john777100/Image_Signal_Processor/synthesis/top_syn.v

/////////////////////////////////////////////////////////////
// Created by: Synopsys DC Ultra(TM) in wire load mode
// Version   : N-2017.09-SP2
// Date      : Thu Jun  4 21:27:11 2020
/////////////////////////////////////////////////////////////


module demosaic ( clk, rst_n, valid, data_in, end_col, end_pic, RGB_valid, 
        RGB_data, color, col_last, pic_last );
  input [7:0] data_in;
  output [7:0] RGB_data;
  output [1:0] color;
  input clk, rst_n, valid, end_col, end_pic;
  output RGB_valid, col_last, pic_last;
  wire   \col1_r[0][7] , \col1_r[0][6] , \col1_r[0][5] , \col1_r[0][4] ,
         \col1_r[0][3] , \col1_r[0][2] , \col1_r[0][1] , \col1_r[0][0] ,
         \col1_r[1][7] , \col1_r[1][6] , \col1_r[1][5] , \col1_r[1][4] ,
         \col1_r[1][3] , \col1_r[1][2] , \col1_r[1][1] , \col1_r[1][0] ,
         \col1_r[2][7] , \col1_r[2][6] , \col1_r[2][5] , \col1_r[2][4] ,
         \col1_r[2][3] , \col1_r[2][2] , \col1_r[2][1] , \col1_r[2][0] ,
         \col1_r[3][7] , \col1_r[3][6] , \col1_r[3][5] , \col1_r[3][4] ,
         \col1_r[3][3] , \col1_r[3][2] , \col1_r[3][1] , \col1_r[3][0] ,
         \col1_r[4][7] , \col1_r[4][6] , \col1_r[4][5] , \col1_r[4][4] ,
         \col1_r[4][3] , \col1_r[4][2] , \col1_r[4][1] , \col1_r[4][0] ,
         \col1_r[5][7] , \col1_r[5][6] , \col1_r[5][5] , \col1_r[5][4] ,
         \col1_r[5][3] , \col1_r[5][2] , \col1_r[5][1] , \col1_r[5][0] ,
         \col1_r[6][7] , \col1_r[6][6] , \col1_r[6][5] , \col1_r[6][4] ,
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
         n1128, n1129, n1130, n1131, n1132, n1133, n1134, n1135, n1136, n1137,
         n1138, n1139, n1140, n1141, n1142, n1143, n1144, n1145, n1146, n1147,
         n1148, n1149, n1150, n1151, n1152, n1153, n1154, n1155, n1156, n1157,
         n1158, n1159, n1160, n1161, n1162, n1163, n1164, \intadd_9/CI ,
         \intadd_9/SUM[6] , \intadd_9/SUM[5] , \intadd_9/SUM[4] ,
         \intadd_9/SUM[3] , \intadd_9/SUM[2] , \intadd_9/SUM[1] ,
         \intadd_9/SUM[0] , \intadd_9/n7 , \intadd_9/n6 , \intadd_9/n5 ,
         \intadd_9/n4 , \intadd_9/n3 , \intadd_9/n2 , \intadd_9/n1 ,
         \intadd_10/CI , \intadd_10/SUM[6] , \intadd_10/SUM[5] ,
         \intadd_10/SUM[4] , \intadd_10/SUM[3] , \intadd_10/SUM[2] ,
         \intadd_10/SUM[1] , \intadd_10/SUM[0] , \intadd_10/n7 ,
         \intadd_10/n6 , \intadd_10/n5 , \intadd_10/n4 , \intadd_10/n3 ,
         \intadd_10/n2 , \intadd_10/n1 , \intadd_11/A[5] , \intadd_11/A[4] ,
         \intadd_11/A[3] , \intadd_11/A[2] , \intadd_11/A[1] ,
         \intadd_11/A[0] , \intadd_11/B[5] , \intadd_11/B[4] ,
         \intadd_11/B[3] , \intadd_11/B[2] , \intadd_11/B[1] ,
         \intadd_11/B[0] , \intadd_11/CI , \intadd_11/SUM[5] ,
         \intadd_11/SUM[4] , \intadd_11/SUM[3] , \intadd_11/SUM[2] ,
         \intadd_11/SUM[1] , \intadd_11/SUM[0] , \intadd_11/n6 ,
         \intadd_11/n5 , \intadd_11/n4 , \intadd_11/n3 , \intadd_11/n2 ,
         \intadd_11/n1 , \intadd_12/A[5] , \intadd_12/A[4] , \intadd_12/A[3] ,
         \intadd_12/A[2] , \intadd_12/A[1] , \intadd_12/A[0] ,
         \intadd_12/B[5] , \intadd_12/B[4] , \intadd_12/B[3] ,
         \intadd_12/B[2] , \intadd_12/B[1] , \intadd_12/B[0] , \intadd_12/CI ,
         \intadd_12/SUM[5] , \intadd_12/SUM[4] , \intadd_12/SUM[3] ,
         \intadd_12/SUM[2] , \intadd_12/SUM[1] , \intadd_12/SUM[0] ,
         \intadd_12/n6 , \intadd_12/n5 , \intadd_12/n4 , \intadd_12/n3 ,
         \intadd_12/n2 , \intadd_12/n1 , n1, n2, n3, n4, n5, n6, n7, n8, n9,
         n10, n11, n12, n13, n14, n15, n16, n17, n18, n19, n20, n21, n22, n23,
         n24, n25, n26, n27, n28, n29, n30, n31, n32, n33, n34, n35, n36, n37,
         n38, n39, n40, n41, n42, n43, n44, n45, n46, n47, n48, n49, n50, n51,
         n52, n53, n54, n55, n56, n57, n58, n59, n60, n61, n62, n63, n64, n65,
         n66, n67, n68, n69, n70, n71, n72, n73, n74, n75, n76, n77, n78, n79,
         n80, n81, n82, n83, n84, n85, n86, n87, n88, n89, n90, n91, n92, n93,
         n94, n95, n96, n97, n98, n99, n100, n101, n102, n103, n104, n105,
         n106, n107, n108, n109, n110, n111, n112, n113, n114, n115, n116,
         n117, n118, n119, n120, n121, n122, n123, n124, n125, n126, n127,
         n128, n129, n130, n131, n132, n133, n134, n135, n136, n137, n138,
         n139, n140, n141, n142, n143, n144, n145, n146, n147, n148, n149,
         n150, n151, n152, n153, n154, n155, n156, n157, n158, n159, n160,
         n161, n162, n163, n164, n165, n166, n167, n168, n169, n170, n171,
         n172, n173, n174, n175, n176, n177, n178, n179, n180, n181, n182,
         n183, n184, n185, n186, n187, n188, n189, n190, n191, n192, n193,
         n194, n195, n196, n197, n198, n199, n200, n201, n202, n203, n204,
         n205, n206, n207, n208, n209, n210, n211, n212, n213, n214, n215,
         n216, n217, n218, n219, n220, n221, n222, n223, n224, n225, n226,
         n227, n228, n229, n230, n231, n232, n233, n234, n235, n236, n237,
         n238, n239, n240, n241, n242, n243, n244, n245, n246, n247, n248,
         n249, n250, n251, n252, n253, n254, n255, n256, n257, n258, n259,
         n260, n261, n262, n263, n264, n265, n266, n267, n268, n269, n270,
         n271, n272, n273, n274, n275, n276, n277, n278, n279, n280, n281,
         n282, n283, n284, n285, n286, n287, n288, n289, n290, n291, n292,
         n293, n294, n295, n296, n297, n298, n299, n300, n301, n302, n303,
         n304, n305, n306, n307, n308, n309, n310, n311, n312, n313, n314,
         n315, n316, n317, n318, n319, n320, n321, n322, n323, n324, n325,
         n326, n327, n328, n329, n330, n331, n332, n333, n334, n335, n336,
         n337, n338, n339, n340, n341, n342, n343, n344, n345, n346, n347,
         n348, n349, n350, n351, n352, n353, n354, n355, n356, n357, n358,
         n359, n360, n361, n362, n363, n364, n365, n366, n367, n368, n369,
         n370, n371, n372, n373, n374, n375, n376, n377, n378, n379, n380,
         n381, n382, n383, n384, n385, n386, n387, n388, n389, n390, n391,
         n392, n393, n394, n395, n396, n397, n398, n399, n400, n401, n402,
         n403, n404, n405, n406, n407, n408, n409, n410, n411, n412, n413,
         n414, n415, n416, n417, n418, n419, n420, n421, n422, n423, n424,
         n425, n426, n427, n428, n429, n430, n431, n432, n433, n434, n435,
         n436, n437, n438, n439, n440, n441, n442, n443, n444, n445, n446,
         n447, n448, n449, n450, n451, n452, n453, n454, n455, n456, n457,
         n458, n459, n460, n461, n462, n463, n464, n465, n466, n467, n468,
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
  wire   [2:0] counter_r;
  wire   [7:0] pixel9;
  wire   [2:0] logic_state_r;
  wire   [9:0] up_sum_r;
  wire   [9:0] down_sum_r;
  wire   [9:0] hor_sum_r;
  wire   [9:0] ver_sum_r;
  wire   [7:0] cen_r;
  wire   [7:0] G_data_r;
  wire   [7:0] B_data_r;
  wire   [3:0] state_r;
  wire   [3:0] state_w;

  QDFFRBN end_col_r_reg ( .D(end_col), .CK(clk), .RB(n851), .Q(end_col_r) );
  QDFFRBN end_pic_r_reg ( .D(end_pic), .CK(clk), .RB(n851), .Q(end_pic_r) );
  QDFFRBN \counter_r_reg[0]  ( .D(n1161), .CK(clk), .RB(n853), .Q(counter_r[0]) );
  QDFFRBN \state_r_reg[3]  ( .D(state_w[3]), .CK(clk), .RB(n853), .Q(
        state_r[3]) );
  QDFFRBN \counter_r_reg[1]  ( .D(n1159), .CK(clk), .RB(n853), .Q(counter_r[1]) );
  QDFFRBN \counter_r_reg[2]  ( .D(n1160), .CK(clk), .RB(n853), .Q(counter_r[2]) );
  QDFFRBN \state_r_reg[2]  ( .D(state_w[2]), .CK(clk), .RB(n852), .Q(
        state_r[2]) );
  QDFFRBN \state_r_reg[1]  ( .D(state_w[1]), .CK(clk), .RB(n852), .Q(
        state_r[1]) );
  QDFFRBN \logic_state_r_reg[2]  ( .D(n1164), .CK(clk), .RB(n848), .Q(
        logic_state_r[2]) );
  QDFFRBN \logic_state_r_reg[0]  ( .D(n1162), .CK(clk), .RB(n848), .Q(
        logic_state_r[0]) );
  QDFFRBN \logic_state_r_reg[1]  ( .D(n1163), .CK(clk), .RB(n859), .Q(
        logic_state_r[1]) );
  QDFFRBN col_last_buf_r_reg ( .D(n973), .CK(clk), .RB(n890), .Q(
        col_last_buf_r) );
  QDFFRBN col_last_r_reg ( .D(n972), .CK(clk), .RB(n890), .Q(col_last) );
  QDFFRBN pic_last_buf_r_reg ( .D(n924), .CK(clk), .RB(n890), .Q(
        pic_last_buf_r) );
  QDFFRBN pic_last_r_reg ( .D(n923), .CK(clk), .RB(n849), .Q(pic_last) );
  QDFFRBN \col3_r_reg[0][7]  ( .D(n1158), .CK(clk), .RB(n849), .Q(
        \col3_r[0][7] ) );
  QDFFRBN \col3_r_reg[0][6]  ( .D(n1157), .CK(clk), .RB(n849), .Q(
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
        .O(n194) );
  AOI22S U407 ( .A1(n668), .A2(\col1_r[5][0] ), .B1(n667), .B2(\col1_r[3][0] ), 
        .O(n193) );
  AOI22S U408 ( .A1(n678), .A2(\col1_r[6][0] ), .B1(n792), .B2(\col1_r[4][0] ), 
        .O(n192) );
  ND3 U409 ( .I1(n194), .I2(n193), .I3(n192), .O(n195) );
  OAI22S U410 ( .A1(n472), .A2(n195), .B1(\col1_r[0][0] ), .B2(n195), .O(n212)
         );
  MOAI1S U411 ( .A1(n213), .A2(n212), .B1(n213), .B2(n212), .O(n196) );
  MOAI1S U412 ( .A1(n369), .A2(n196), .B1(hor_sum_r[0]), .B2(n370), .O(n954)
         );
  AOI22S U413 ( .A1(n416), .A2(\col3_r[1][1] ), .B1(n423), .B2(\col3_r[0][1] ), 
        .O(n201) );
  INV1S U414 ( .I(n604), .O(n790) );
  AOI22S U415 ( .A1(n737), .A2(\col3_r[5][1] ), .B1(n790), .B2(\col3_r[4][1] ), 
        .O(n200) );
  AOI22S U416 ( .A1(n738), .A2(\col3_r[2][1] ), .B1(n770), .B2(\col3_r[3][1] ), 
        .O(n199) );
  ND3 U417 ( .I1(n201), .I2(n200), .I3(n199), .O(n733) );
  MOAI1S U418 ( .A1(n732), .A2(n733), .B1(n732), .B2(n733), .O(n205) );
  AOI22S U419 ( .A1(n416), .A2(\col1_r[1][1] ), .B1(\col1_r[0][1] ), .B2(n287), 
        .O(n204) );
  AOI22S U420 ( .A1(n737), .A2(\col1_r[5][1] ), .B1(n781), .B2(\col1_r[4][1] ), 
        .O(n203) );
  AOI22S U421 ( .A1(\col1_r[2][1] ), .A2(n784), .B1(\col1_r[3][1] ), .B2(n775), 
        .O(n202) );
  ND3 U422 ( .I1(n204), .I2(n203), .I3(n202), .O(n734) );
  MOAI1S U423 ( .A1(n205), .A2(n734), .B1(n205), .B2(n734), .O(n207) );
  BUF1 U424 ( .I(n206), .O(n310) );
  MOAI1S U425 ( .A1(n363), .A2(n207), .B1(up_sum_r[1]), .B2(n310), .O(n933) );
  MOAI1S U426 ( .A1(\intadd_11/SUM[0] ), .A2(n300), .B1(up_sum_r[2]), .B2(n310), .O(n932) );
  INV1S U427 ( .I(n422), .O(n466) );
  AOI22S U428 ( .A1(n466), .A2(\col1_r[2][1] ), .B1(\col1_r[1][1] ), .B2(n287), 
        .O(n210) );
  INV1S U429 ( .I(n597), .O(n677) );
  INV1S U430 ( .I(n260), .O(n646) );
  AOI22S U431 ( .A1(n677), .A2(\col1_r[5][1] ), .B1(n646), .B2(\col1_r[3][1] ), 
        .O(n209) );
  AOI22S U432 ( .A1(n678), .A2(\col1_r[6][1] ), .B1(\col1_r[4][1] ), .B2(n775), 
        .O(n208) );
  ND3 U433 ( .I1(n210), .I2(n209), .I3(n208), .O(n211) );
  INV1S U434 ( .I(n415), .O(n495) );
  OAI22S U435 ( .A1(\col1_r[0][1] ), .A2(n211), .B1(n495), .B2(n211), .O(n707)
         );
  NR2 U436 ( .I1(n213), .I2(n212), .O(n709) );
  AOI22S U437 ( .A1(n466), .A2(\col3_r[2][1] ), .B1(n788), .B2(\col3_r[1][1] ), 
        .O(n216) );
  INV1S U438 ( .I(n260), .O(n676) );
  AOI22S U439 ( .A1(n668), .A2(\col3_r[5][1] ), .B1(n676), .B2(\col3_r[3][1] ), 
        .O(n215) );
  INV1S U440 ( .I(n742), .O(n467) );
  AOI22S U441 ( .A1(n467), .A2(\col3_r[6][1] ), .B1(n792), .B2(\col3_r[4][1] ), 
        .O(n214) );
  ND3 U442 ( .I1(n216), .I2(n215), .I3(n214), .O(n217) );
  AO12 U443 ( .B1(n495), .B2(\col3_r[0][1] ), .A1(n217), .O(n708) );
  MOAI1S U444 ( .A1(n709), .A2(n708), .B1(n709), .B2(n708), .O(n218) );
  MOAI1S U445 ( .A1(n707), .A2(n218), .B1(n707), .B2(n218), .O(n219) );
  MOAI1S U446 ( .A1(n369), .A2(n219), .B1(hor_sum_r[1]), .B2(n310), .O(n953)
         );
  MOAI1S U447 ( .A1(\intadd_11/SUM[1] ), .A2(n300), .B1(up_sum_r[3]), .B2(n310), .O(n931) );
  MOAI1S U448 ( .A1(\intadd_12/SUM[0] ), .A2(n300), .B1(hor_sum_r[2]), .B2(
        n370), .O(n952) );
  MOAI1S U449 ( .A1(\intadd_11/SUM[2] ), .A2(n300), .B1(up_sum_r[4]), .B2(n310), .O(n930) );
  MOAI1S U450 ( .A1(\intadd_12/SUM[1] ), .A2(n372), .B1(hor_sum_r[3]), .B2(
        n370), .O(n951) );
  INV1S U451 ( .I(n623), .O(n615) );
  AOI22S U452 ( .A1(n615), .A2(\col1_r[7][5] ), .B1(n555), .B2(\col1_r[1][5] ), 
        .O(n224) );
  INV1S U453 ( .I(n743), .O(n350) );
  INV1S U454 ( .I(n589), .O(n337) );
  AOI22S U455 ( .A1(n350), .A2(\col1_r[4][5] ), .B1(n337), .B2(\col1_r[5][5] ), 
        .O(n223) );
  INV1S U456 ( .I(n417), .O(n347) );
  AOI22S U457 ( .A1(n291), .A2(\col1_r[3][5] ), .B1(n347), .B2(\col1_r[6][5] ), 
        .O(n221) );
  INV1S U458 ( .I(n736), .O(n563) );
  AOI22S U459 ( .A1(n563), .A2(\col1_r[2][5] ), .B1(n154), .B2(\col1_r[0][5] ), 
        .O(n220) );
  AN2 U460 ( .I1(n221), .I2(n220), .O(n222) );
  ND3 U461 ( .I1(n224), .I2(n223), .I3(n222), .O(n307) );
  INV1S U462 ( .I(n742), .O(n782) );
  AOI22S U463 ( .A1(n782), .A2(\col1_r[7][4] ), .B1(n555), .B2(\col1_r[1][4] ), 
        .O(n229) );
  INV1S U464 ( .I(n743), .O(n338) );
  INV1S U465 ( .I(n589), .O(n524) );
  AOI22S U466 ( .A1(n338), .A2(\col1_r[4][4] ), .B1(n524), .B2(\col1_r[5][4] ), 
        .O(n228) );
  INV1S U467 ( .I(n735), .O(n346) );
  INV1S U468 ( .I(n604), .O(n341) );
  AOI22S U469 ( .A1(n346), .A2(\col1_r[3][4] ), .B1(n341), .B2(\col1_r[6][4] ), 
        .O(n226) );
  AOI22S U470 ( .A1(n563), .A2(\col1_r[2][4] ), .B1(n155), .B2(\col1_r[0][4] ), 
        .O(n225) );
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
  MOAI1S U602 ( .A1(n369), .A2(n336), .B1(n717), .B2(ver_sum_r[6]), .O(n958)
         );
  MOAI1S U603 ( .A1(\intadd_12/SUM[3] ), .A2(n372), .B1(hor_sum_r[5]), .B2(
        n370), .O(n949) );
  AOI22S U604 ( .A1(n338), .A2(\col2_r[4][7] ), .B1(n337), .B2(\col2_r[5][7] ), 
        .O(n340) );
  AOI22S U605 ( .A1(n495), .A2(\col2_r[1][7] ), .B1(n393), .B2(\col2_r[7][7] ), 
        .O(n339) );
  AN2 U606 ( .I1(n340), .I2(n339), .O(n345) );
  AOI22S U607 ( .A1(n346), .A2(\col2_r[3][7] ), .B1(n341), .B2(\col2_r[6][7] ), 
        .O(n344) );
  AOI22S U608 ( .A1(n342), .A2(\col2_r[2][7] ), .B1(\col2_r[0][7] ), .B2(n154), 
        .O(n343) );
  ND3 U609 ( .I1(n345), .I2(n344), .I3(n343), .O(n366) );
  AOI22S U610 ( .A1(n346), .A2(\col2_r[1][7] ), .B1(n522), .B2(\col2_r[0][7] ), 
        .O(n353) );
  AOI22S U611 ( .A1(n348), .A2(\col2_r[5][7] ), .B1(n347), .B2(\col2_r[4][7] ), 
        .O(n352) );
  AOI22S U612 ( .A1(n350), .A2(\col2_r[2][7] ), .B1(n349), .B2(\col2_r[3][7] ), 
        .O(n351) );
  ND3 U613 ( .I1(n353), .I2(n352), .I3(n351), .O(n365) );
  FA1S U614 ( .A(n356), .B(n355), .CI(n354), .CO(n364), .S(n335) );
  INV1S U615 ( .I(n357), .O(n358) );
  MOAI1S U616 ( .A1(n369), .A2(n358), .B1(n717), .B2(ver_sum_r[8]), .O(n956)
         );
  FA1S U617 ( .A(n130), .B(n360), .CI(n359), .CO(n318), .S(n361) );
  INV1S U618 ( .I(n361), .O(n362) );
  MOAI1S U619 ( .A1(n363), .A2(n362), .B1(n24), .B2(down_sum_r[7]), .O(n937)
         );
  MOAI1S U620 ( .A1(\intadd_11/SUM[5] ), .A2(n798), .B1(up_sum_r[7]), .B2(n797), .O(n927) );
  FA1S U621 ( .A(n366), .B(n365), .CI(n364), .CO(n357), .S(n367) );
  INV1S U622 ( .I(n367), .O(n368) );
  MOAI1S U623 ( .A1(n369), .A2(n368), .B1(n717), .B2(ver_sum_r[7]), .O(n957)
         );
  MOAI1S U624 ( .A1(\intadd_12/SUM[4] ), .A2(n372), .B1(hor_sum_r[6]), .B2(n24), .O(n948) );
  MOAI1S U625 ( .A1(\intadd_12/SUM[5] ), .A2(n372), .B1(hor_sum_r[7]), .B2(
        n370), .O(n947) );
  MOAI1S U626 ( .A1(\intadd_12/n1 ), .A2(n372), .B1(hor_sum_r[8]), .B2(n371), 
        .O(n946) );
  NR2 U627 ( .I1(n509), .I2(n376), .O(n373) );
  NR3 U628 ( .I1(n509), .I2(logic_state_r[1]), .I3(logic_state_r[2]), .O(n374)
         );
  AOI22S U629 ( .A1(cen_r[1]), .A2(n127), .B1(B_data_r[1]), .B2(n100), .O(n379) );
  NR2 U630 ( .I1(logic_state_r[0]), .I2(n376), .O(n377) );
  AOI22S U631 ( .A1(n106), .A2(\intadd_9/SUM[1] ), .B1(ver_sum_r[2]), .B2(n126), .O(n378) );
  ND3 U632 ( .I1(n380), .I2(n379), .I3(n378), .O(n908) );
  AOI22S U633 ( .A1(cen_r[0]), .A2(n128), .B1(B_data_r[0]), .B2(n101), .O(n382) );
  AOI22S U634 ( .A1(n106), .A2(\intadd_9/SUM[0] ), .B1(ver_sum_r[1]), .B2(n125), .O(n381) );
  ND3 U635 ( .I1(n383), .I2(n382), .I3(n381), .O(n907) );
  AOI22S U636 ( .A1(cen_r[2]), .A2(n374), .B1(B_data_r[2]), .B2(n102), .O(n385) );
  AOI22S U637 ( .A1(n107), .A2(\intadd_9/SUM[2] ), .B1(ver_sum_r[3]), .B2(n377), .O(n384) );
  ND3 U638 ( .I1(n386), .I2(n385), .I3(n384), .O(n909) );
  AOI22S U639 ( .A1(cen_r[3]), .A2(n127), .B1(B_data_r[3]), .B2(n100), .O(n388) );
  AOI22S U640 ( .A1(n108), .A2(\intadd_9/SUM[3] ), .B1(ver_sum_r[4]), .B2(n126), .O(n387) );
  ND3 U641 ( .I1(n389), .I2(n388), .I3(n387), .O(n910) );
  AOI22S U642 ( .A1(cen_r[4]), .A2(n128), .B1(B_data_r[4]), .B2(n101), .O(n391) );
  AOI22S U643 ( .A1(n107), .A2(\intadd_9/SUM[4] ), .B1(ver_sum_r[5]), .B2(n125), .O(n390) );
  ND3 U644 ( .I1(n392), .I2(n391), .I3(n390), .O(n911) );
  NR2 U645 ( .I1(n393), .I2(end_col_r), .O(n538) );
  INV1S U646 ( .I(n538), .O(n492) );
  NR2 U647 ( .I1(n492), .I2(n409), .O(n474) );
  INV1S U648 ( .I(n505), .O(n520) );
  INV1S U649 ( .I(n21), .O(n497) );
  AOI22S U650 ( .A1(n474), .A2(n528), .B1(n109), .B2(n497), .O(n398) );
  INV1S U651 ( .I(end_col_r), .O(n631) );
  MOAI1S U652 ( .A1(n503), .A2(state_r[2]), .B1(n503), .B2(n18), .O(n394) );
  INV1S U653 ( .I(state_r[1]), .O(n487) );
  AO13S U654 ( .B1(n116), .B2(n540), .B3(n394), .A1(n487), .O(n397) );
  NR2 U655 ( .I1(n847), .I2(n623), .O(n395) );
  INV1S U656 ( .I(n532), .O(n476) );
  ND3 U657 ( .I1(n398), .I2(n397), .I3(n396), .O(state_w[1]) );
  AOI22S U658 ( .A1(cen_r[5]), .A2(n374), .B1(B_data_r[5]), .B2(n102), .O(n400) );
  AOI22S U659 ( .A1(n106), .A2(\intadd_9/SUM[5] ), .B1(ver_sum_r[6]), .B2(n377), .O(n399) );
  ND3 U660 ( .I1(n401), .I2(n400), .I3(n399), .O(n912) );
  ND2S U661 ( .I1(n128), .I2(cen_r[7]), .O(n404) );
  AOI22S U662 ( .A1(hor_sum_r[8]), .A2(n373), .B1(B_data_r[7]), .B2(n100), .O(
        n403) );
  AOI22S U663 ( .A1(n107), .A2(\intadd_9/n1 ), .B1(ver_sum_r[8]), .B2(n126), 
        .O(n402) );
  ND3 U664 ( .I1(n404), .I2(n403), .I3(n402), .O(n914) );
  AOI22S U665 ( .A1(cen_r[6]), .A2(n127), .B1(B_data_r[6]), .B2(n101), .O(n406) );
  AOI22S U666 ( .A1(n108), .A2(\intadd_9/SUM[6] ), .B1(ver_sum_r[7]), .B2(n125), .O(n405) );
  ND3 U667 ( .I1(n407), .I2(n406), .I3(n405), .O(n913) );
  ND2S U668 ( .I1(RGB_valid), .I2(n809), .O(n408) );
  ND2S U669 ( .I1(n408), .I2(n75), .O(RGB_valid_w) );
  ND2S U670 ( .I1(n811), .I2(n410), .O(n1163) );
  AOI22S U671 ( .A1(n416), .A2(\col1_r[2][7] ), .B1(n423), .B2(\col1_r[1][7] ), 
        .O(n413) );
  INV1S U672 ( .I(n597), .O(n661) );
  AOI22S U673 ( .A1(n661), .A2(\col1_r[5][7] ), .B1(n523), .B2(\col1_r[3][7] ), 
        .O(n412) );
  AOI22S U674 ( .A1(n737), .A2(\col1_r[6][7] ), .B1(n436), .B2(\col1_r[4][7] ), 
        .O(n411) );
  ND3 U675 ( .I1(n413), .I2(n412), .I3(n411), .O(n414) );
  OAI22S U676 ( .A1(n521), .A2(n414), .B1(\col1_r[0][7] ), .B2(n414), .O(
        \intadd_12/B[5] ) );
  INV1S U677 ( .I(n415), .O(n446) );
  AOI22S U678 ( .A1(n416), .A2(\col3_r[2][7] ), .B1(n423), .B2(\col3_r[1][7] ), 
        .O(n420) );
  INV1S U679 ( .I(n417), .O(n653) );
  AOI22S U680 ( .A1(n653), .A2(\col3_r[5][7] ), .B1(n676), .B2(\col3_r[3][7] ), 
        .O(n419) );
  INV1S U681 ( .I(n742), .O(n441) );
  AOI22S U682 ( .A1(n441), .A2(\col3_r[6][7] ), .B1(n436), .B2(\col3_r[4][7] ), 
        .O(n418) );
  ND3 U683 ( .I1(n420), .I2(n419), .I3(n418), .O(n421) );
  OAI22S U684 ( .A1(n446), .A2(n421), .B1(\col3_r[0][7] ), .B2(n421), .O(
        \intadd_12/A[5] ) );
  INV1S U685 ( .I(n422), .O(n447) );
  AOI22S U686 ( .A1(n447), .A2(\col1_r[2][6] ), .B1(n423), .B2(\col1_r[1][6] ), 
        .O(n426) );
  AOI22S U687 ( .A1(n653), .A2(\col1_r[5][6] ), .B1(n523), .B2(\col1_r[3][6] ), 
        .O(n425) );
  AOI22S U688 ( .A1(n441), .A2(\col1_r[6][6] ), .B1(n436), .B2(\col1_r[4][6] ), 
        .O(n424) );
  ND3 U689 ( .I1(n426), .I2(n425), .I3(n424), .O(n427) );
  OAI22S U690 ( .A1(n446), .A2(n427), .B1(\col1_r[0][6] ), .B2(n427), .O(
        \intadd_12/B[4] ) );
  INV1S U691 ( .I(n566), .O(n452) );
  AOI22S U692 ( .A1(n447), .A2(\col3_r[2][6] ), .B1(n452), .B2(\col3_r[1][6] ), 
        .O(n430) );
  AOI22S U693 ( .A1(n661), .A2(\col3_r[5][6] ), .B1(n676), .B2(\col3_r[3][6] ), 
        .O(n429) );
  AOI22S U694 ( .A1(n441), .A2(\col3_r[6][6] ), .B1(n436), .B2(\col3_r[4][6] ), 
        .O(n428) );
  ND3 U695 ( .I1(n430), .I2(n429), .I3(n428), .O(n431) );
  OAI22S U696 ( .A1(n446), .A2(n431), .B1(\col3_r[0][6] ), .B2(n431), .O(
        \intadd_12/A[4] ) );
  AOI22S U697 ( .A1(n447), .A2(\col1_r[2][5] ), .B1(n452), .B2(\col1_r[1][5] ), 
        .O(n434) );
  AOI22S U698 ( .A1(n653), .A2(\col1_r[5][5] ), .B1(n523), .B2(\col1_r[3][5] ), 
        .O(n433) );
  INV1S U699 ( .I(n747), .O(n461) );
  AOI22S U700 ( .A1(n441), .A2(\col1_r[6][5] ), .B1(n461), .B2(\col1_r[4][5] ), 
        .O(n432) );
  ND3 U701 ( .I1(n434), .I2(n433), .I3(n432), .O(n435) );
  OAI22S U702 ( .A1(n446), .A2(n435), .B1(\col1_r[0][5] ), .B2(n435), .O(
        \intadd_12/B[3] ) );
  AOI22S U703 ( .A1(n447), .A2(\col3_r[2][5] ), .B1(n452), .B2(\col3_r[1][5] ), 
        .O(n439) );
  AOI22S U704 ( .A1(n677), .A2(\col3_r[5][5] ), .B1(n676), .B2(\col3_r[3][5] ), 
        .O(n438) );
  AOI22S U705 ( .A1(n441), .A2(\col3_r[6][5] ), .B1(n436), .B2(\col3_r[4][5] ), 
        .O(n437) );
  ND3 U706 ( .I1(n439), .I2(n438), .I3(n437), .O(n440) );
  OAI22S U707 ( .A1(n446), .A2(n440), .B1(\col3_r[0][5] ), .B2(n440), .O(
        \intadd_12/A[3] ) );
  AOI22S U708 ( .A1(n447), .A2(\col1_r[2][4] ), .B1(n452), .B2(\col1_r[1][4] ), 
        .O(n444) );
  AOI22S U709 ( .A1(n661), .A2(\col1_r[5][4] ), .B1(n646), .B2(\col1_r[3][4] ), 
        .O(n443) );
  AOI22S U710 ( .A1(n441), .A2(\col1_r[6][4] ), .B1(n461), .B2(\col1_r[4][4] ), 
        .O(n442) );
  ND3 U711 ( .I1(n444), .I2(n443), .I3(n442), .O(n445) );
  OAI22S U712 ( .A1(n446), .A2(n445), .B1(\col1_r[0][4] ), .B2(n445), .O(
        \intadd_12/B[2] ) );
  AOI22S U713 ( .A1(n447), .A2(\col3_r[2][4] ), .B1(n452), .B2(\col3_r[1][4] ), 
        .O(n450) );
  AOI22S U714 ( .A1(n677), .A2(\col3_r[5][4] ), .B1(n646), .B2(\col3_r[3][4] ), 
        .O(n449) );
  AOI22S U715 ( .A1(n467), .A2(\col3_r[6][4] ), .B1(n461), .B2(\col3_r[4][4] ), 
        .O(n448) );
  ND3 U716 ( .I1(n450), .I2(n449), .I3(n448), .O(n451) );
  OAI22S U717 ( .A1(n472), .A2(n451), .B1(\col3_r[0][4] ), .B2(n451), .O(
        \intadd_12/A[2] ) );
  AOI22S U718 ( .A1(n466), .A2(\col1_r[2][3] ), .B1(n452), .B2(\col1_r[1][3] ), 
        .O(n455) );
  AOI22S U719 ( .A1(n661), .A2(\col1_r[5][3] ), .B1(n523), .B2(\col1_r[3][3] ), 
        .O(n454) );
  AOI22S U720 ( .A1(n467), .A2(\col1_r[6][3] ), .B1(n461), .B2(\col1_r[4][3] ), 
        .O(n453) );
  ND3 U721 ( .I1(n455), .I2(n454), .I3(n453), .O(n456) );
  OAI22S U722 ( .A1(n472), .A2(n456), .B1(\col1_r[0][3] ), .B2(n456), .O(
        \intadd_12/B[1] ) );
  AOI22S U723 ( .A1(n466), .A2(\col3_r[2][3] ), .B1(n788), .B2(\col3_r[1][3] ), 
        .O(n459) );
  AOI22S U724 ( .A1(n653), .A2(\col3_r[5][3] ), .B1(n646), .B2(\col3_r[3][3] ), 
        .O(n458) );
  AOI22S U725 ( .A1(n467), .A2(\col3_r[6][3] ), .B1(n461), .B2(\col3_r[4][3] ), 
        .O(n457) );
  ND3 U726 ( .I1(n459), .I2(n458), .I3(n457), .O(n460) );
  OAI22S U727 ( .A1(n472), .A2(n460), .B1(\col3_r[0][3] ), .B2(n460), .O(
        \intadd_12/A[1] ) );
  AOI22S U728 ( .A1(n466), .A2(\col1_r[2][2] ), .B1(n788), .B2(\col1_r[1][2] ), 
        .O(n464) );
  AOI22S U729 ( .A1(n661), .A2(\col1_r[5][2] ), .B1(n646), .B2(\col1_r[3][2] ), 
        .O(n463) );
  AOI22S U730 ( .A1(n467), .A2(\col1_r[6][2] ), .B1(n461), .B2(\col1_r[4][2] ), 
        .O(n462) );
  ND3 U731 ( .I1(n464), .I2(n463), .I3(n462), .O(n465) );
  OAI22S U732 ( .A1(n472), .A2(n465), .B1(\col1_r[0][2] ), .B2(n465), .O(
        \intadd_12/CI ) );
  AOI22S U733 ( .A1(n466), .A2(\col3_r[2][2] ), .B1(n788), .B2(\col3_r[1][2] ), 
        .O(n470) );
  AOI22S U734 ( .A1(n668), .A2(\col3_r[5][2] ), .B1(n676), .B2(\col3_r[3][2] ), 
        .O(n469) );
  AOI22S U735 ( .A1(n467), .A2(\col3_r[6][2] ), .B1(n792), .B2(\col3_r[4][2] ), 
        .O(n468) );
  ND3 U736 ( .I1(n470), .I2(n469), .I3(n468), .O(n471) );
  OAI22S U737 ( .A1(n472), .A2(n471), .B1(\col3_r[0][2] ), .B2(n471), .O(
        \intadd_12/B[0] ) );
  NR2 U738 ( .I1(n532), .I2(n505), .O(n488) );
  AOI13HS U739 ( .B1(state_r[2]), .B2(n503), .B3(n505), .A1(n488), .O(n535) );
  AO13S U740 ( .B1(n528), .B2(n531), .B3(n498), .A1(state_r[3]), .O(n473) );
  AOI22S U741 ( .A1(n116), .A2(n475), .B1(n474), .B2(n505), .O(n517) );
  OA12 U742 ( .B1(n21), .B2(n520), .A1(state_r[3]), .O(n500) );
  AOI13HS U743 ( .B1(n476), .B2(n487), .B3(n847), .A1(n500), .O(n530) );
  MOAI1S U744 ( .A1(counter_r[0]), .A2(n517), .B1(counter_r[0]), .B2(n515), 
        .O(n1161) );
  AOI13HS U745 ( .B1(state_r[1]), .B2(n113), .B3(n631), .A1(n497), .O(n477) );
  INV1S U746 ( .I(n115), .O(n533) );
  NR2 U747 ( .I1(n477), .I2(n533), .O(n482) );
  ND2S U748 ( .I1(n18), .I2(n631), .O(n478) );
  AOI22S U749 ( .A1(state_r[3]), .A2(n478), .B1(state_r[1]), .B2(n782), .O(
        n480) );
  AOI13HS U750 ( .B1(n480), .B2(n505), .B3(n479), .A1(n21), .O(n481) );
  MOAI1S U751 ( .A1(n482), .A2(n847), .B1(n116), .B2(n481), .O(state_w[0]) );
  NR2 U752 ( .I1(n109), .I2(n495), .O(n483) );
  NR3 U753 ( .I1(state_r[3]), .I2(n484), .I3(n483), .O(n491) );
  ND2S U754 ( .I1(state_r[0]), .I2(n485), .O(n486) );
  ND3 U755 ( .I1(n487), .I2(n631), .I3(n486), .O(n489) );
  MOAI1S U756 ( .A1(n113), .A2(n489), .B1(n488), .B2(n495), .O(n490) );
  MOAI1S U757 ( .A1(n491), .A2(n497), .B1(n115), .B2(n490), .O(state_w[2]) );
  NR2 U758 ( .I1(state_r[1]), .I2(n18), .O(n493) );
  NR2 U759 ( .I1(n493), .I2(n492), .O(n494) );
  NR2 U760 ( .I1(n494), .I2(n533), .O(n502) );
  NR2 U761 ( .I1(n520), .I2(n497), .O(n496) );
  MOAI1S U762 ( .A1(n498), .A2(n497), .B1(n496), .B2(n495), .O(n499) );
  NR2 U763 ( .I1(n500), .I2(n499), .O(n501) );
  OAI22S U764 ( .A1(n113), .A2(n502), .B1(n533), .B2(n501), .O(state_w[3]) );
  NR2 U765 ( .I1(n811), .I2(logic_state_r[1]), .O(n842) );
  INV1S U766 ( .I(n531), .O(n504) );
  MOAI1S U767 ( .A1(n505), .A2(n518), .B1(n519), .B2(n504), .O(n506) );
  OR3B2S U768 ( .I1(n77), .B1(n115), .B2(n506), .O(n507) );
  OAI112HS U769 ( .C1(n510), .C2(n509), .A1(n508), .B1(n507), .O(n1162) );
  XOR2HS U770 ( .I1(n511), .I2(counter_r[2]), .O(n512) );
  MOAI1S U771 ( .A1(n512), .A2(n517), .B1(n23), .B2(n515), .O(n1160) );
  AN2 U772 ( .I1(n514), .I2(n513), .O(n516) );
  MOAI1S U773 ( .A1(n517), .A2(n516), .B1(counter_r[1]), .B2(n515), .O(n1159)
         );
  MOAI1S U774 ( .A1(n520), .A2(n519), .B1(n520), .B2(n518), .O(n537) );
  OAI22S U775 ( .A1(n535), .A2(n533), .B1(n537), .B2(n533), .O(n525) );
  MOAI1S U776 ( .A1(n129), .A2(n83), .B1(\col3_r[0][7] ), .B2(n81), .O(n1158)
         );
  MOAI1S U777 ( .A1(n132), .A2(n81), .B1(\col3_r[0][6] ), .B2(n82), .O(n1157)
         );
  MOAI1S U778 ( .A1(n135), .A2(n82), .B1(\col3_r[0][5] ), .B2(n83), .O(n1156)
         );
  MOAI1S U779 ( .A1(n138), .A2(n83), .B1(\col3_r[0][4] ), .B2(n81), .O(n1155)
         );
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
  AOI22S U1111 ( .A1(n782), .A2(\col1_r[5][6] ), .B1(n774), .B2(\col1_r[4][6] ), .O(n777) );
  AOI22S U1112 ( .A1(n784), .A2(\col1_r[2][6] ), .B1(n775), .B2(\col1_r[3][6] ), .O(n776) );
  AOI22S U1113 ( .A1(n780), .A2(\col3_r[1][7] ), .B1(n779), .B2(\col3_r[0][7] ), .O(n787) );
  AOI22S U1114 ( .A1(n782), .A2(\col3_r[5][7] ), .B1(n781), .B2(\col3_r[4][7] ), .O(n786) );
  AOI22S U1115 ( .A1(n784), .A2(\col3_r[2][7] ), .B1(n783), .B2(\col3_r[3][7] ), .O(n785) );
  AOI22S U1116 ( .A1(n789), .A2(\col1_r[1][7] ), .B1(n788), .B2(\col1_r[0][7] ), .O(n796) );
  AOI22S U1117 ( .A1(n791), .A2(\col1_r[5][7] ), .B1(n790), .B2(\col1_r[4][7] ), .O(n795) );
  AOI22S U1118 ( .A1(n793), .A2(\col1_r[2][7] ), .B1(n792), .B2(\col1_r[3][7] ), .O(n794) );
  MOAI1S U1119 ( .A1(\intadd_11/n1 ), .A2(n798), .B1(up_sum_r[8]), .B2(n797), 
        .O(n926) );
  INV1S U1120 ( .I(end_pic_r), .O(n800) );
  MOAI1S U1121 ( .A1(n801), .A2(n800), .B1(n799), .B2(pic_last_buf_r), .O(n924) );
  NR2 U1122 ( .I1(ver_sum_r[1]), .I2(hor_sum_r[1]), .O(n803) );
  ND2S U1123 ( .I1(ver_sum_r[0]), .I2(hor_sum_r[0]), .O(n802) );
  MOAI1S U1124 ( .A1(n803), .A2(n802), .B1(ver_sum_r[1]), .B2(hor_sum_r[1]), 
        .O(\intadd_10/CI ) );
  AO222 U1125 ( .A1(n100), .A2(G_data_r[7]), .B1(n66), .B2(\intadd_10/n1 ), 
        .C1(cen_r[7]), .C2(n804), .O(n922) );
  AO222 U1126 ( .A1(n65), .A2(\intadd_10/SUM[6] ), .B1(n102), .B2(G_data_r[6]), 
        .C1(cen_r[6]), .C2(n804), .O(n921) );
  AO222 U1127 ( .A1(n66), .A2(\intadd_10/SUM[5] ), .B1(n100), .B2(G_data_r[5]), 
        .C1(cen_r[5]), .C2(n804), .O(n920) );
  AO222 U1128 ( .A1(n65), .A2(\intadd_10/SUM[4] ), .B1(n101), .B2(G_data_r[4]), 
        .C1(cen_r[4]), .C2(n804), .O(n919) );
  AO222 U1129 ( .A1(n66), .A2(\intadd_10/SUM[3] ), .B1(n102), .B2(G_data_r[3]), 
        .C1(cen_r[3]), .C2(n804), .O(n918) );
  AO222 U1130 ( .A1(n65), .A2(\intadd_10/SUM[2] ), .B1(n100), .B2(G_data_r[2]), 
        .C1(cen_r[2]), .C2(n112), .O(n917) );
  AO222 U1131 ( .A1(n66), .A2(\intadd_10/SUM[1] ), .B1(n101), .B2(G_data_r[1]), 
        .C1(cen_r[1]), .C2(n112), .O(n916) );
  AO222 U1132 ( .A1(n65), .A2(\intadd_10/SUM[0] ), .B1(n102), .B2(G_data_r[0]), 
        .C1(cen_r[0]), .C2(n112), .O(n915) );
  NR2 U1133 ( .I1(down_sum_r[1]), .I2(up_sum_r[1]), .O(n806) );
  ND2S U1134 ( .I1(down_sum_r[0]), .I2(up_sum_r[0]), .O(n805) );
  MOAI1S U1135 ( .A1(n806), .A2(n805), .B1(down_sum_r[1]), .B2(up_sum_r[1]), 
        .O(\intadd_9/CI ) );
  ND2S U1136 ( .I1(logic_state_r[1]), .I2(n20), .O(n808) );
  ND2S U1137 ( .I1(n809), .I2(n808), .O(n807) );
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
