john777100/Image_Signal_Processor/apr/top_syn.v

/////////////////////////////////////////////////////////////
// Created by: Synopsys DC Ultra(TM) in wire load mode
// Version   : N-2017.09-SP2
// Date      : Fri May 29 00:54:54 2020
/////////////////////////////////////////////////////////////


module demosaic ( clk, rst_n, valid, data_in, end_col, end_pic, RGB_valid, 
        RGB_data, color, col_last, pic_last );
  input [7:0] data_in;
  output [7:0] RGB_data;
  output [1:0] color;
  input clk, rst_n, valid, end_col, end_pic;
  output RGB_valid, col_last, pic_last;
  wire   \col1_r[0][0] , \col1_r[1][0] , \col1_r[4][1] , \col2_r[4][7] ,
         \col2_r[4][6] , \col2_r[4][5] , \col2_r[4][4] , \col2_r[4][3] ,
         \col2_r[4][2] , \col2_r[4][1] , \col2_r[4][0] , \col3_r[0][1] ,
         \col3_r[0][0] , \col3_r[1][1] , \col3_r[1][0] , col_last_buf_r,
         pic_last_buf_r, end_col_r, end_pic_r, valid_r, RGB_valid_w, n1016,
         n1017, n1018, n1019, n1020, n1021, n1022, n1023, n1024, n1025, n1026,
         n1027, n1028, n1029, n1030, n1031, n1032, n1033, n1034, n1035, n1036,
         n1037, n1038, n1039, n1040, n1041, n1042, n1043, n1044, n1046, n1047,
         n1048, n1049, n1050, n1051, n1052, n1053, n1054, n1056, n1057, n1058,
         n1059, n1060, n1061, n1062, n1063, n1064, n1066, n1067, n1068, n1069,
         n1070, n1071, n1072, n1073, n1074, n1076, n1077, n1078, n1079, n1080,
         n1081, n1082, n1083, n1084, n1085, n1086, n1087, n1088, n1089, n1090,
         n1091, n1092, n1093, n1094, n1095, n1096, n1097, n1098, n1099, n1100,
         n1101, n1102, n1103, n1104, n1105, n1106, n1107, n1108, n1109, n1110,
         n1111, n1112, n1113, n1114, n1115, n1116, n1117, n1118, n1119, n1120,
         n1121, n1122, n1123, n1124, n1125, n1126, n1127, n1128, n1129, n1130,
         n1131, n1132, n1133, n1134, n1135, n1136, n1137, n1138, n1139, n1140,
         n1141, n1142, n1143, n1144, n1145, n1146, n1147, n1148, n1149, n1150,
         n1151, n1152, n1153, n1154, n1155, n1156, n1157, n1158, n1159, n1160,
         n1161, n1162, n1163, n1164, n1165, n1166, n1167, n1168, n1169, n1170,
         n1171, n1172, n1173, n1174, n1175, n1176, n1177, n1178, n1179, n1180,
         n1181, n1182, n1183, n1184, n1185, n1186, n1187, n1188, n1189, n1190,
         n1191, n1192, n1193, n1194, n1195, n1196, n1197, n1198, n1199, n1200,
         n1201, n1202, n1203, n1204, n1205, n1206, n1207, n1208, n1209, n1210,
         n1211, n1212, n1213, n1214, n1215, n1216, n1217, n1218, n1219, n1220,
         n1221, n1222, n1223, n1224, n1225, n1226, n1227, n1228, n1229, n1230,
         n1231, n1232, n1233, n1234, n1235, n1236, n1237, n1238, n1239, n1240,
         n1241, n1242, n1243, n1244, n1245, n1246, n1247, n1248, n1249, n1250,
         n1251, n1252, n1253, n1254, n1255, n1256, n1257, n1258, n1259, n1260,
         n1261, n1262, n1263, n1264, n1265, n1266, n1267, n1268, n1269, n1270,
         n1271, n1272, n1273, n1274, n1275, n1276, n1277, n1278, n1279, n1280,
         n1281, n1282, n1283, n1284, \intadd_7/CI , \intadd_7/SUM[6] ,
         \intadd_7/SUM[5] , \intadd_7/SUM[4] , \intadd_7/SUM[3] ,
         \intadd_7/SUM[2] , \intadd_7/SUM[1] , \intadd_7/SUM[0] ,
         \intadd_7/n7 , \intadd_7/n6 , \intadd_7/n5 , \intadd_7/n4 ,
         \intadd_7/n3 , \intadd_7/n2 , \intadd_7/n1 , \intadd_8/CI ,
         \intadd_8/SUM[6] , \intadd_8/SUM[5] , \intadd_8/SUM[4] ,
         \intadd_8/SUM[3] , \intadd_8/SUM[2] , \intadd_8/SUM[1] ,
         \intadd_8/SUM[0] , \intadd_8/n7 , \intadd_8/n6 , \intadd_8/n5 ,
         \intadd_8/n4 , \intadd_8/n3 , \intadd_8/n2 , \intadd_8/n1 ,
         \intadd_9/A[5] , \intadd_9/A[4] , \intadd_9/A[3] , \intadd_9/A[2] ,
         \intadd_9/A[1] , \intadd_9/A[0] , \intadd_9/B[5] , \intadd_9/B[4] ,
         \intadd_9/B[3] , \intadd_9/B[2] , \intadd_9/B[1] , \intadd_9/B[0] ,
         \intadd_9/CI , \intadd_9/SUM[5] , \intadd_9/SUM[4] ,
         \intadd_9/SUM[3] , \intadd_9/SUM[2] , \intadd_9/SUM[1] ,
         \intadd_9/SUM[0] , \intadd_9/n6 , \intadd_9/n5 , \intadd_9/n4 ,
         \intadd_9/n3 , \intadd_9/n2 , \intadd_9/n1 , n1, n2, n3, n4, n5, n6,
         n10, n11, n12, n13, n14, n15, n16, n17, n18, n19, n20, n21, n22, n23,
         n24, n25, n26, n27, n28, n29, n30, n31, n32, n33, n34, n35, n36, n37,
         n38, n39, n40, n41, n42, n43, n44, n45, n46, n47, n48, n49, n50, n51,
         n52, n53, n54, n55, n56, n57, n58, n59, n60, n61, n62, n63, n64, n65,
         n66, n67, n68, n69, n70, n71, n72, n73, n74, n75, n76, n77, n78, n79,
         n80, n81, n82, n83, n84, n85, n86, n87, n88, n89, n90, n91, n92, n93,
         n94, n95, n96, n97, n98, n99, n100, n101, n102, n103, n104, n105,
         n106, n107, n108, n109, n110, n111, n112, n113, n114, n115, n116,
         n117, n118, n119, n120, n121, n122, n123, n124, n125, n126, n127,
         n128, n129, n130, n131, n132, n133, n134, n135, n136, n137, n138,
         n139, n140, n141, n142, n143, n144, n145, n146, n147, n148, n149,
         n150, n151, n152, n153, n154, n155, n156, n157, n158, n159, n160,
         n161, n162, n163, n164, n165, n166, n167, n168, n169, n170, n171,
         n172, n173, n174, n175, n176, n177, n178, n179, n180, n181, n182,
         n183, n184, n185, n186, n187, n188, n189, n190, n191, n192, n193,
         n194, n195, n196, n197, n198, n199, n200, n201, n202, n203, n204,
         n205, n206, n207, n208, n209, n210, n211, n212, n213, n214, n215,
         n216, n217, n218, n219, n220, n221, n222, n223, n224, n225, n226,
         n227, n228, n229, n230, n231, n232, n233, n234, n235, n236, n237,
         n238, n239, n240, n241, n242, n243, n244, n245, n246, n247, n248,
         n249, n250, n251, n252, n253, n254, n255, n256, n257, n258, n259,
         n260, n261, n262, n263, n264, n265, n266, n267, n268, n269, n270,
         n271, n272, n273, n274, n275, n276, n277, n278, n279, n280, n281,
         n282, n283, n284, n285, n286, n287, n288, n289, n290, n291, n292,
         n293, n294, n295, n296, n297, n298, n299, n300, n301, n302, n303,
         n304, n305, n306, n307, n308, n309, n310, n311, n312, n313, n314,
         n315, n316, n317, n318, n319, n320, n321, n322, n323, n324, n325,
         n326, n327, n328, n329, n330, n331, n332, n333, n334, n335, n336,
         n337, n338, n339, n340, n341, n342, n343, n344, n345, n346, n347,
         n348, n349, n350, n351, n352, n353, n354, n355, n356, n357, n358,
         n359, n360, n361, n362, n363, n364, n365, n366, n367, n368, n369,
         n370, n371, n372, n373, n374, n375, n376, n377, n378, n379, n380,
         n381, n382, n383, n384, n385, n386, n387, n388, n389, n390, n391,
         n392, n393, n394, n395, n396, n397, n398, n399, n400, n401, n402,
         n403, n404, n405, n406, n407, n408, n409, n410, n411, n412, n413,
         n414, n415, n416, n417, n418, n419, n420, n421, n422, n423, n424,
         n425, n426, n427, n428, n429, n430, n431, n432, n433, n434, n435,
         n436, n437, n438, n439, n440, n441, n442, n443, n444, n445, n446,
         n447, n448, n449, n450, n451, n452, n453, n454, n455, n456, n457,
         n458, n459, n460, n461, n462, n463, n464, n465, n466, n467, n468,
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
  wire   [2:0] counter_r;
  wire   [7:0] pixel9;
  wire   [2:0] logic_state_r;
  wire   [9:0] up_sum_r;
  wire   [9:0] down_sum_r;
  wire   [9:0] hor_sum_r;
  wire   [9:0] ver_sum_r;
  wire   [7:0] cen_r;
  wire   [7:0] G_data_r;
  wire   [7:0] B_data_r;
  wire   [3:0] state_r;
  wire   [3:0] state_w;

  DFFRX1 end_col_r_reg ( .D(end_col), .CK(clk), .RN(n777), .Q(end_col_r), .QN(
        n620) );
  DFFRX1 end_pic_r_reg ( .D(end_pic), .CK(clk), .RN(rst_n), .Q(end_pic_r) );
  DFFRX1 \state_r_reg[3]  ( .D(state_w[3]), .CK(clk), .RN(rst_n), .Q(
        state_r[3]), .QN(n692) );
  DFFRX1 \counter_r_reg[1]  ( .D(n1279), .CK(clk), .RN(rst_n), .Q(counter_r[1]), .QN(n619) );
  DFFRX1 \logic_state_r_reg[2]  ( .D(n1284), .CK(clk), .RN(n780), .Q(
        logic_state_r[2]), .QN(n722) );
  DFFRX1 \logic_state_r_reg[0]  ( .D(n1282), .CK(clk), .RN(n780), .Q(
        logic_state_r[0]), .QN(n635) );
  DFFRX1 \logic_state_r_reg[1]  ( .D(n1283), .CK(clk), .RN(n780), .Q(
        logic_state_r[1]), .QN(n16) );
  DFFRX1 col_last_buf_r_reg ( .D(n1093), .CK(clk), .RN(n780), .Q(
        col_last_buf_r) );
  DFFRX1 col_last_r_reg ( .D(n1092), .CK(clk), .RN(n780), .Q(col_last) );
  DFFRX1 pic_last_buf_r_reg ( .D(n1044), .CK(clk), .RN(n780), .Q(
        pic_last_buf_r) );
  DFFRX1 pic_last_r_reg ( .D(n1043), .CK(clk), .RN(n780), .Q(pic_last) );
  DFFRX1 \col3_r_reg[0][7]  ( .D(n1278), .CK(clk), .RN(rst_n), .QN(n740) );
  DFFRX1 \col3_r_reg[0][6]  ( .D(n1277), .CK(clk), .RN(rst_n), .QN(n739) );
  DFFRX1 \col3_r_reg[0][5]  ( .D(n1276), .CK(clk), .RN(rst_n), .QN(n738) );
  DFFRX1 \col3_r_reg[0][4]  ( .D(n1275), .CK(clk), .RN(rst_n), .QN(n737) );
  DFFRX1 \col3_r_reg[0][3]  ( .D(n1274), .CK(clk), .RN(n4), .QN(n736) );
  DFFRX1 \col3_r_reg[0][2]  ( .D(n1273), .CK(clk), .RN(n4), .QN(n735) );
  DFFRX1 \col3_r_reg[0][1]  ( .D(n1272), .CK(clk), .RN(n4), .Q(\col3_r[0][1] ), 
        .QN(n754) );
  DFFRX1 \col3_r_reg[0][0]  ( .D(n1271), .CK(clk), .RN(n4), .Q(\col3_r[0][0] ), 
        .QN(n711) );
  DFFRX1 \col3_r_reg[1][7]  ( .D(n1270), .CK(clk), .RN(n4), .QN(n675) );
  DFFRX1 \col3_r_reg[1][6]  ( .D(n1269), .CK(clk), .RN(n4), .QN(n672) );
  DFFRX1 \col3_r_reg[1][5]  ( .D(n1268), .CK(clk), .RN(n4), .QN(n669) );
  DFFRX1 \col3_r_reg[1][4]  ( .D(n1267), .CK(clk), .RN(n4), .QN(n666) );
  DFFRX1 \col3_r_reg[1][3]  ( .D(n1266), .CK(clk), .RN(n778), .QN(n596) );
  DFFRX1 \col3_r_reg[1][2]  ( .D(n1265), .CK(clk), .RN(rst_n), .QN(n639) );
  DFFRX1 \col3_r_reg[1][1]  ( .D(n1264), .CK(clk), .RN(rst_n), .Q(
        \col3_r[1][1] ), .QN(n713) );
  DFFRX1 \col3_r_reg[1][0]  ( .D(n1263), .CK(clk), .RN(rst_n), .Q(
        \col3_r[1][0] ), .QN(n714) );
  DFFRX1 \col3_r_reg[2][7]  ( .D(n1262), .CK(clk), .RN(rst_n), .QN(n745) );
  DFFRX1 \col3_r_reg[2][6]  ( .D(n1261), .CK(clk), .RN(rst_n), .QN(n744) );
  DFFRX1 \col3_r_reg[2][5]  ( .D(n1260), .CK(clk), .RN(rst_n), .QN(n743) );
  DFFRX1 \col3_r_reg[2][4]  ( .D(n1259), .CK(clk), .RN(rst_n), .QN(n742) );
  DFFRX1 \col3_r_reg[2][3]  ( .D(n1258), .CK(clk), .RN(rst_n), .QN(n642) );
  DFFRX1 \col3_r_reg[2][2]  ( .D(n1257), .CK(clk), .RN(rst_n), .QN(n703) );
  DFFRX1 \col3_r_reg[2][1]  ( .D(n1256), .CK(clk), .RN(rst_n), .QN(n592) );
  DFFRX1 \col3_r_reg[2][0]  ( .D(n1255), .CK(clk), .RN(rst_n), .QN(n584) );
  DFFRX1 \col3_r_reg[3][7]  ( .D(n1254), .CK(clk), .RN(n4), .QN(n753) );
  DFFRX1 \col3_r_reg[3][6]  ( .D(n1253), .CK(clk), .RN(n4), .QN(n752) );
  DFFRX1 \col3_r_reg[3][5]  ( .D(n1252), .CK(clk), .RN(n781), .QN(n751) );
  DFFRX1 \col3_r_reg[3][4]  ( .D(n1251), .CK(clk), .RN(n4), .QN(n750) );
  DFFRX1 \col3_r_reg[3][3]  ( .D(n1250), .CK(clk), .RN(n4), .QN(n710) );
  DFFRX1 \col3_r_reg[3][2]  ( .D(n1249), .CK(clk), .RN(n4), .QN(n709) );
  DFFRX1 \col3_r_reg[3][1]  ( .D(n1248), .CK(clk), .RN(n4), .QN(n630) );
  DFFRX1 \col3_r_reg[3][0]  ( .D(n1247), .CK(clk), .RN(n4), .QN(n693) );
  DFFRX1 \col3_r_reg[4][7]  ( .D(n1246), .CK(clk), .RN(n781), .QN(n677) );
  DFFRX1 \col3_r_reg[4][6]  ( .D(n1245), .CK(clk), .RN(n4), .QN(n674) );
  DFFRX1 \col3_r_reg[4][5]  ( .D(n1244), .CK(clk), .RN(n4), .QN(n671) );
  DFFRX1 \col3_r_reg[4][4]  ( .D(n1243), .CK(clk), .RN(n781), .QN(n668) );
  DFFRX1 \col3_r_reg[4][3]  ( .D(n1242), .CK(clk), .RN(n4), .QN(n643) );
  DFFRX1 \col3_r_reg[4][2]  ( .D(n1241), .CK(clk), .RN(n4), .QN(n641) );
  DFFRX1 \col3_r_reg[4][1]  ( .D(n1240), .CK(clk), .RN(n4), .QN(n705) );
  DFFRX1 \col3_r_reg[4][0]  ( .D(n1239), .CK(clk), .RN(n4), .QN(n623) );
  DFFRX1 \col3_r_reg[5][7]  ( .D(n1238), .CK(clk), .RN(n4), .QN(n676) );
  DFFRX1 \col3_r_reg[5][6]  ( .D(n1237), .CK(clk), .RN(n781), .QN(n673) );
  DFFRX1 \col3_r_reg[5][5]  ( .D(n1236), .CK(clk), .RN(n4), .QN(n670) );
  DFFRX1 \col3_r_reg[5][4]  ( .D(n1235), .CK(clk), .RN(n4), .QN(n667) );
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
  DFFRX1 \B_data_r_reg[0]  ( .D(n1027), .CK(clk), .RN(n4), .Q(B_data_r[0]) );
  DFFRX1 \color_r_reg[1]  ( .D(n1026), .CK(clk), .RN(n4), .Q(color[1]) );
  DFFRX1 \color_r_reg[0]  ( .D(n1025), .CK(clk), .RN(n4), .Q(color[0]) );
  DFFRX1 \state_r_reg[0]  ( .D(n1024), .CK(clk), .RN(n4), .Q(n618), .QN(
        state_r[0]) );
  DFFRX1 \RGB_data_r_reg[7]  ( .D(n1023), .CK(clk), .RN(n4), .Q(RGB_data[7])
         );
  DFFRX1 \RGB_data_r_reg[6]  ( .D(n1022), .CK(clk), .RN(n4), .Q(RGB_data[6])
         );
  DFFRX1 \RGB_data_r_reg[5]  ( .D(n1021), .CK(clk), .RN(n4), .Q(RGB_data[5])
         );
  DFFRX1 \RGB_data_r_reg[4]  ( .D(n1020), .CK(clk), .RN(n4), .Q(RGB_data[4])
         );
  DFFRX1 \RGB_data_r_reg[3]  ( .D(n1019), .CK(clk), .RN(rst_n), .Q(RGB_data[3]) );
  DFFRX1 \RGB_data_r_reg[2]  ( .D(n1018), .CK(clk), .RN(rst_n), .Q(RGB_data[2]) );
  DFFRX1 \RGB_data_r_reg[1]  ( .D(n1017), .CK(clk), .RN(rst_n), .Q(RGB_data[1]) );
  DFFRX1 \RGB_data_r_reg[0]  ( .D(n1016), .CK(clk), .RN(rst_n), .Q(RGB_data[0]) );
  ADDFX1 \intadd_7/U8  ( .A(down_sum_r[2]), .B(up_sum_r[2]), .CI(\intadd_7/CI ), .CO(\intadd_7/n7 ), .S(\intadd_7/SUM[0] ) );
  ADDFX1 \intadd_7/U7  ( .A(down_sum_r[3]), .B(up_sum_r[3]), .CI(\intadd_7/n7 ), .CO(\intadd_7/n6 ), .S(\intadd_7/SUM[1] ) );
  ADDFX1 \intadd_7/U6  ( .A(down_sum_r[4]), .B(up_sum_r[4]), .CI(\intadd_7/n6 ), .CO(\intadd_7/n5 ), .S(\intadd_7/SUM[2] ) );
  ADDFX1 \intadd_7/U5  ( .A(down_sum_r[5]), .B(up_sum_r[5]), .CI(\intadd_7/n5 ), .CO(\intadd_7/n4 ), .S(\intadd_7/SUM[3] ) );
  ADDFX1 \intadd_7/U4  ( .A(down_sum_r[6]), .B(up_sum_r[6]), .CI(\intadd_7/n4 ), .CO(\intadd_7/n3 ), .S(\intadd_7/SUM[4] ) );
  ADDFX1 \intadd_7/U3  ( .A(down_sum_r[7]), .B(up_sum_r[7]), .CI(\intadd_7/n3 ), .CO(\intadd_7/n2 ), .S(\intadd_7/SUM[5] ) );
  ADDFX1 \intadd_7/U2  ( .A(down_sum_r[8]), .B(up_sum_r[8]), .CI(\intadd_7/n2 ), .CO(\intadd_7/n1 ), .S(\intadd_7/SUM[6] ) );
  ADDFX1 \intadd_8/U8  ( .A(ver_sum_r[2]), .B(hor_sum_r[2]), .CI(\intadd_8/CI ), .CO(\intadd_8/n7 ), .S(\intadd_8/SUM[0] ) );
  ADDFX1 \intadd_8/U7  ( .A(ver_sum_r[3]), .B(hor_sum_r[3]), .CI(\intadd_8/n7 ), .CO(\intadd_8/n6 ), .S(\intadd_8/SUM[1] ) );
  ADDFX1 \intadd_8/U3  ( .A(ver_sum_r[7]), .B(hor_sum_r[7]), .CI(\intadd_8/n3 ), .CO(\intadd_8/n2 ), .S(\intadd_8/SUM[5] ) );
  ADDFX1 \intadd_8/U2  ( .A(ver_sum_r[8]), .B(hor_sum_r[8]), .CI(\intadd_8/n2 ), .CO(\intadd_8/n1 ), .S(\intadd_8/SUM[6] ) );
  ADDFX1 \intadd_8/U6  ( .A(ver_sum_r[4]), .B(hor_sum_r[4]), .CI(\intadd_8/n6 ), .CO(\intadd_8/n5 ), .S(\intadd_8/SUM[2] ) );
  ADDFX1 \intadd_8/U5  ( .A(ver_sum_r[5]), .B(hor_sum_r[5]), .CI(\intadd_8/n5 ), .CO(\intadd_8/n4 ), .S(\intadd_8/SUM[3] ) );
  ADDFX1 \intadd_8/U4  ( .A(ver_sum_r[6]), .B(hor_sum_r[6]), .CI(\intadd_8/n4 ), .CO(\intadd_8/n3 ), .S(\intadd_8/SUM[4] ) );
  ADDFX1 \intadd_9/U3  ( .A(\intadd_9/A[4] ), .B(\intadd_9/B[4] ), .CI(
        \intadd_9/n3 ), .CO(\intadd_9/n2 ), .S(\intadd_9/SUM[4] ) );
  ADDFX1 \intadd_9/U6  ( .A(\intadd_9/A[1] ), .B(\intadd_9/B[1] ), .CI(
        \intadd_9/n6 ), .CO(\intadd_9/n5 ), .S(\intadd_9/SUM[1] ) );
  ADDFX1 \intadd_9/U7  ( .A(\intadd_9/A[0] ), .B(\intadd_9/B[0] ), .CI(
        \intadd_9/CI ), .CO(\intadd_9/n6 ), .S(\intadd_9/SUM[0] ) );
  ADDFX1 \intadd_9/U2  ( .A(\intadd_9/A[5] ), .B(\intadd_9/B[5] ), .CI(
        \intadd_9/n2 ), .CO(\intadd_9/n1 ), .S(\intadd_9/SUM[5] ) );
  ADDFX1 \intadd_9/U4  ( .A(\intadd_9/A[3] ), .B(\intadd_9/B[3] ), .CI(
        \intadd_9/n4 ), .CO(\intadd_9/n3 ), .S(\intadd_9/SUM[3] ) );
  ADDFX1 \intadd_9/U5  ( .A(\intadd_9/A[2] ), .B(\intadd_9/B[2] ), .CI(
        \intadd_9/n5 ), .CO(\intadd_9/n4 ), .S(\intadd_9/SUM[2] ) );
  DFFRX2 \state_r_reg[1]  ( .D(state_w[1]), .CK(clk), .RN(n780), .Q(state_r[1]), .QN(n691) );
  DFFRX2 valid_r_reg ( .D(valid), .CK(clk), .RN(n780), .Q(valid_r), .QN(n688)
         );
  DFFRX2 \counter_r_reg[0]  ( .D(n1281), .CK(clk), .RN(rst_n), .Q(counter_r[0]), .QN(n689) );
  DFFRX2 \counter_r_reg[2]  ( .D(n1280), .CK(clk), .RN(rst_n), .Q(counter_r[2]), .QN(n574) );
  DFFRX1 \state_r_reg[2]  ( .D(state_w[2]), .CK(clk), .RN(rst_n), .Q(
        state_r[2]), .QN(n690) );
  DFFRX1 \data_in_r_reg[0]  ( .D(data_in[0]), .CK(clk), .RN(n780), .Q(
        pixel9[0]) );
  DFFRX1 \data_in_r_reg[1]  ( .D(data_in[1]), .CK(clk), .RN(n778), .Q(
        pixel9[1]) );
  DFFRX1 \data_in_r_reg[2]  ( .D(data_in[2]), .CK(clk), .RN(rst_n), .Q(
        pixel9[2]) );
  DFFRX1 \data_in_r_reg[3]  ( .D(data_in[3]), .CK(clk), .RN(rst_n), .Q(
        pixel9[3]) );
  DFFRX1 \data_in_r_reg[4]  ( .D(data_in[4]), .CK(clk), .RN(n777), .Q(
        pixel9[4]) );
  DFFRX1 \data_in_r_reg[5]  ( .D(data_in[5]), .CK(clk), .RN(n780), .Q(
        pixel9[5]) );
  DFFRX1 \data_in_r_reg[6]  ( .D(data_in[6]), .CK(clk), .RN(n780), .Q(
        pixel9[6]) );
  DFFRX1 \data_in_r_reg[7]  ( .D(data_in[7]), .CK(clk), .RN(n780), .Q(
        pixel9[7]) );
  CLKBUFX8 U3 ( .A(rst_n), .Y(n781) );
  OAI31X1 U4 ( .A0(state_r[0]), .A1(state_r[1]), .A2(n181), .B0(n186), .Y(n202) );
  AOI2BB2X1 U5 ( .B0(n541), .B1(\col1_r[1][0] ), .A0N(n540), .A1N(n694), .Y(
        n534) );
  INVX12 U6 ( .A(n569), .Y(n17) );
  INVX12 U7 ( .A(n545), .Y(n30) );
  INVXL U8 ( .A(n223), .Y(n24) );
  AO22X4 U9 ( .A0(n72), .A1(B_data_r[1]), .B0(n73), .B1(\intadd_7/SUM[1] ), 
        .Y(n87) );
  AOI2BB2X2 U10 ( .B0(n553), .B1(n551), .A0N(n553), .A1N(n551), .Y(n552) );
  AO22X4 U11 ( .A0(valid_r), .A1(n184), .B0(state_r[2]), .B1(n183), .Y(
        state_w[2]) );
  AO21X4 U12 ( .A0(color[1]), .A1(n559), .B0(n72), .Y(n1026) );
  AO22X4 U13 ( .A0(n295), .A1(n294), .B0(ver_sum_r[0]), .B1(n407), .Y(n1084)
         );
  AO22X4 U14 ( .A0(n295), .A1(n408), .B0(hor_sum_r[2]), .B1(n407), .Y(n1072)
         );
  AO22X4 U15 ( .A0(n295), .A1(n530), .B0(down_sum_r[8]), .B1(n407), .Y(n1056)
         );
  AO22X4 U16 ( .A0(pic_last_buf_r), .A1(n558), .B0(pic_last), .B1(n557), .Y(
        n1043) );
  CLKBUFX8 U17 ( .A(n177), .Y(n5) );
  CLKBUFX8 U18 ( .A(n177), .Y(n1) );
  INVX4 U19 ( .A(n248), .Y(n295) );
  INVX6 U20 ( .A(n286), .Y(n407) );
  CLKBUFX8 U21 ( .A(n546), .Y(n6) );
  INVX4 U22 ( .A(n541), .Y(n546) );
  INVX6 U23 ( .A(n32), .Y(n2) );
  INVX8 U24 ( .A(n31), .Y(n3) );
  BUFX16 U25 ( .A(n781), .Y(n4) );
  AO22X1 U26 ( .A0(n295), .A1(n472), .B0(hor_sum_r[8]), .B1(n407), .Y(n1066)
         );
  AO22X1 U27 ( .A0(n295), .A1(n375), .B0(ver_sum_r[8]), .B1(n407), .Y(n1076)
         );
  AO22X1 U28 ( .A0(n295), .A1(n468), .B0(hor_sum_r[7]), .B1(n407), .Y(n1067)
         );
  AO22X1 U29 ( .A0(n295), .A1(n371), .B0(ver_sum_r[7]), .B1(n407), .Y(n1077)
         );
  AO22X1 U30 ( .A0(n295), .A1(n456), .B0(hor_sum_r[6]), .B1(n407), .Y(n1068)
         );
  AO22X1 U31 ( .A0(n295), .A1(n527), .B0(down_sum_r[7]), .B1(n407), .Y(n1057)
         );
  AO22X1 U32 ( .A0(n295), .A1(n360), .B0(ver_sum_r[6]), .B1(n407), .Y(n1078)
         );
  AO22X1 U33 ( .A0(n295), .A1(n349), .B0(ver_sum_r[5]), .B1(n407), .Y(n1079)
         );
  AO22X1 U34 ( .A0(n295), .A1(n444), .B0(hor_sum_r[5]), .B1(n407), .Y(n1069)
         );
  AO22X1 U35 ( .A0(n295), .A1(n519), .B0(down_sum_r[6]), .B1(n407), .Y(n1058)
         );
  AO22X1 U36 ( .A0(n295), .A1(n512), .B0(down_sum_r[5]), .B1(n407), .Y(n1059)
         );
  AO22X1 U37 ( .A0(n295), .A1(n432), .B0(hor_sum_r[4]), .B1(n407), .Y(n1070)
         );
  AO22X1 U38 ( .A0(n295), .A1(n338), .B0(ver_sum_r[4]), .B1(n407), .Y(n1080)
         );
  AO22X1 U39 ( .A0(n295), .A1(n505), .B0(down_sum_r[4]), .B1(n407), .Y(n1060)
         );
  AO22X1 U40 ( .A0(n295), .A1(n420), .B0(hor_sum_r[3]), .B1(n407), .Y(n1071)
         );
  AO22X1 U41 ( .A0(n295), .A1(n327), .B0(ver_sum_r[3]), .B1(n407), .Y(n1081)
         );
  AO22X1 U42 ( .A0(n295), .A1(n316), .B0(ver_sum_r[2]), .B1(n407), .Y(n1082)
         );
  AO22X1 U43 ( .A0(n295), .A1(n497), .B0(down_sum_r[3]), .B1(n407), .Y(n1061)
         );
  AO22X1 U44 ( .A0(n295), .A1(n490), .B0(down_sum_r[2]), .B1(n407), .Y(n1062)
         );
  AO22X1 U45 ( .A0(n72), .A1(B_data_r[6]), .B0(n73), .B1(\intadd_7/SUM[6] ), 
        .Y(n125) );
  AO22X1 U46 ( .A0(ver_sum_r[1]), .A1(n407), .B0(n295), .B1(n305), .Y(n1083)
         );
  AO22X1 U47 ( .A0(hor_sum_r[1]), .A1(n407), .B0(n295), .B1(n395), .Y(n1073)
         );
  AO22X1 U48 ( .A0(n72), .A1(B_data_r[7]), .B0(n73), .B1(\intadd_7/n1 ), .Y(
        n129) );
  AO22X1 U49 ( .A0(n295), .A1(n384), .B0(hor_sum_r[0]), .B1(n407), .Y(n1074)
         );
  AO22X1 U50 ( .A0(down_sum_r[1]), .A1(n407), .B0(n295), .B1(n483), .Y(n1063)
         );
  AO22X1 U51 ( .A0(n72), .A1(B_data_r[5]), .B0(n73), .B1(\intadd_7/SUM[5] ), 
        .Y(n95) );
  AOI2BB2X1 U52 ( .B0(n556), .B1(n554), .A0N(n556), .A1N(n554), .Y(n551) );
  AO22X1 U53 ( .A0(n72), .A1(B_data_r[4]), .B0(n73), .B1(\intadd_7/SUM[4] ), 
        .Y(n91) );
  AO22X1 U54 ( .A0(n295), .A1(n477), .B0(down_sum_r[0]), .B1(n407), .Y(n1064)
         );
  AO22X1 U55 ( .A0(n72), .A1(B_data_r[3]), .B0(n73), .B1(\intadd_7/SUM[3] ), 
        .Y(n83) );
  AO22X1 U56 ( .A0(n295), .A1(end_pic_r), .B0(pic_last_buf_r), .B1(n407), .Y(
        n1044) );
  AO22X1 U57 ( .A0(n72), .A1(B_data_r[2]), .B0(n73), .B1(\intadd_7/SUM[2] ), 
        .Y(n74) );
  AO22X1 U58 ( .A0(col_last_buf_r), .A1(n558), .B0(col_last), .B1(n557), .Y(
        n1092) );
  AO22X1 U59 ( .A0(ver_sum_r[5]), .A1(n69), .B0(hor_sum_r[5]), .B1(n71), .Y(
        n92) );
  AO22X1 U60 ( .A0(ver_sum_r[4]), .A1(n69), .B0(hor_sum_r[4]), .B1(n71), .Y(
        n84) );
  AO22X1 U61 ( .A0(ver_sum_r[6]), .A1(n69), .B0(hor_sum_r[6]), .B1(n71), .Y(
        n96) );
  AO22X1 U62 ( .A0(ver_sum_r[1]), .A1(n69), .B0(hor_sum_r[1]), .B1(n71), .Y(
        n80) );
  AO22X1 U63 ( .A0(n72), .A1(B_data_r[0]), .B0(n73), .B1(\intadd_7/SUM[0] ), 
        .Y(n79) );
  NOR2X1 U64 ( .A(n209), .B(n688), .Y(n14) );
  AO22X1 U65 ( .A0(ver_sum_r[2]), .A1(n69), .B0(hor_sum_r[2]), .B1(n71), .Y(
        n88) );
  AO22X1 U66 ( .A0(ver_sum_r[3]), .A1(n69), .B0(hor_sum_r[3]), .B1(n71), .Y(
        n75) );
  OA21XL U67 ( .A0(n209), .A1(n620), .B0(n210), .Y(n51) );
  NOR3X1 U68 ( .A(state_r[1]), .B(n618), .C(n181), .Y(n22) );
  AO22X1 U69 ( .A0(ver_sum_r[8]), .A1(n69), .B0(hor_sum_r[8]), .B1(n71), .Y(
        n130) );
  AO22X1 U70 ( .A0(ver_sum_r[7]), .A1(n69), .B0(hor_sum_r[7]), .B1(n71), .Y(
        n126) );
  NAND2X4 U71 ( .A(valid_r), .B(n247), .Y(n248) );
  BUFX12 U72 ( .A(n134), .Y(n547) );
  NAND2X1 U73 ( .A(n250), .B(n560), .Y(n247) );
  AND3X4 U74 ( .A(counter_r[2]), .B(counter_r[1]), .C(n689), .Y(n32) );
  NOR3X2 U75 ( .A(logic_state_r[2]), .B(logic_state_r[1]), .C(n635), .Y(n73)
         );
  AND3X2 U76 ( .A(counter_r[0]), .B(n574), .C(n619), .Y(n31) );
  CLKBUFX8 U77 ( .A(rst_n), .Y(n780) );
  INVX2 U78 ( .A(n10), .Y(n11) );
  INVX2 U79 ( .A(n237), .Y(n238) );
  AO21X2 U80 ( .A0(up_sum_r[0]), .A1(n407), .B0(n539), .Y(n1054) );
  INVX2 U81 ( .A(n214), .Y(n215) );
  NAND2X4 U82 ( .A(n27), .B(n26), .Y(n177) );
  INVX2 U83 ( .A(n212), .Y(n213) );
  INVX2 U84 ( .A(n221), .Y(n222) );
  INVX2 U85 ( .A(n224), .Y(n225) );
  INVX2 U86 ( .A(n218), .Y(n219) );
  INVX2 U87 ( .A(n227), .Y(n228) );
  INVX2 U88 ( .A(n216), .Y(n217) );
  NOR2X1 U89 ( .A(n209), .B(n25), .Y(n27) );
  NAND2X1 U90 ( .A(n51), .B(n50), .Y(n53) );
  AO22X1 U91 ( .A0(valid_r), .A1(n191), .B0(n566), .B1(n190), .Y(state_w[3])
         );
  NOR2X1 U92 ( .A(end_col_r), .B(n17), .Y(n26) );
  INVX2 U93 ( .A(n13), .Y(n226) );
  NAND2X2 U94 ( .A(n133), .B(n99), .Y(n100) );
  INVX1 U95 ( .A(n61), .Y(n52) );
  NOR2X1 U96 ( .A(n14), .B(n15), .Y(n13) );
  AOI2BB2X1 U97 ( .B0(n541), .B1(\col3_r[1][1] ), .A0N(n540), .A1N(n630), .Y(
        n542) );
  AOI2BB2X1 U98 ( .B0(n541), .B1(\col3_r[1][0] ), .A0N(n540), .A1N(n693), .Y(
        n531) );
  NAND2BX1 U99 ( .AN(n563), .B(n562), .Y(n1025) );
  NOR2X4 U100 ( .A(n635), .B(n70), .Y(n69) );
  NOR2X4 U101 ( .A(logic_state_r[0]), .B(n70), .Y(n71) );
  BUFX12 U102 ( .A(n24), .Y(n540) );
  INVX2 U103 ( .A(n73), .Y(n99) );
  NAND2X4 U104 ( .A(n28), .B(n574), .Y(n29) );
  INVX2 U105 ( .A(n250), .Y(n72) );
  OAI21X2 U106 ( .A0(n16), .A1(n561), .B0(n560), .Y(n67) );
  INVX2 U107 ( .A(n185), .Y(n564) );
  NOR3X2 U108 ( .A(logic_state_r[0]), .B(logic_state_r[1]), .C(n722), .Y(n65)
         );
  NAND2X1 U109 ( .A(state_r[1]), .B(n618), .Y(n192) );
  NOR2X2 U110 ( .A(logic_state_r[2]), .B(n16), .Y(n68) );
  AOI211XL U111 ( .A0(n32), .A1(\col2_r[4][3] ), .B0(n318), .C0(n317), .Y(n319) );
  NOR3XL U112 ( .A(n398), .B(n397), .C(n396), .Y(n399) );
  NOR3XL U113 ( .A(n411), .B(n410), .C(n409), .Y(n412) );
  NOR3XL U114 ( .A(n423), .B(n422), .C(n421), .Y(n424) );
  NOR3XL U115 ( .A(n435), .B(n434), .C(n433), .Y(n436) );
  BUFX2 U116 ( .A(n22), .Y(n49) );
  AOI211XL U117 ( .A0(n32), .A1(\col2_r[4][5] ), .B0(n340), .C0(n339), .Y(n341) );
  AOI211XL U118 ( .A0(n32), .A1(\col2_r[4][6] ), .B0(n351), .C0(n350), .Y(n352) );
  NOR3XL U119 ( .A(n402), .B(n401), .C(n400), .Y(n403) );
  NOR3XL U120 ( .A(n415), .B(n414), .C(n413), .Y(n416) );
  NOR3XL U121 ( .A(n427), .B(n426), .C(n425), .Y(n428) );
  NOR3XL U122 ( .A(n439), .B(n438), .C(n437), .Y(n440) );
  NOR3XL U123 ( .A(n451), .B(n450), .C(n449), .Y(n452) );
  NOR3XL U124 ( .A(n459), .B(n458), .C(n457), .Y(n460) );
  NOR3XL U125 ( .A(n146), .B(n145), .C(n144), .Y(\intadd_9/A[1] ) );
  NOR3XL U126 ( .A(n143), .B(n142), .C(n141), .Y(\intadd_9/B[1] ) );
  NOR3XL U127 ( .A(n152), .B(n151), .C(n150), .Y(\intadd_9/A[2] ) );
  NOR3XL U128 ( .A(n149), .B(n148), .C(n147), .Y(\intadd_9/B[2] ) );
  NOR3XL U129 ( .A(n158), .B(n157), .C(n156), .Y(\intadd_9/A[3] ) );
  NOR3XL U130 ( .A(n155), .B(n154), .C(n153), .Y(\intadd_9/B[3] ) );
  NOR3XL U131 ( .A(n161), .B(n160), .C(n159), .Y(\intadd_9/B[4] ) );
  BUFX2 U132 ( .A(state_r[3]), .Y(n566) );
  NOR2X1 U133 ( .A(state_r[2]), .B(n566), .Y(n23) );
  XNOR2X1 U134 ( .A(n574), .B(n205), .Y(n203) );
  NOR2X2 U135 ( .A(n618), .B(n691), .Y(n185) );
  NAND2X2 U136 ( .A(n211), .B(n62), .Y(n54) );
  NAND2X2 U137 ( .A(n211), .B(n48), .Y(n44) );
  INVXL U138 ( .A(n38), .Y(n10) );
  NAND2XL U139 ( .A(n223), .B(n48), .Y(n38) );
  NAND2X2 U140 ( .A(n545), .B(n48), .Y(n40) );
  NAND2X2 U141 ( .A(n48), .B(n31), .Y(n42) );
  NAND2X2 U142 ( .A(n541), .B(n48), .Y(n34) );
  NAND2X2 U143 ( .A(n569), .B(n48), .Y(n241) );
  INVX4 U144 ( .A(pixel9[0]), .Y(n240) );
  INVX4 U145 ( .A(pixel9[1]), .Y(n236) );
  INVX4 U146 ( .A(pixel9[4]), .Y(n233) );
  INVX4 U147 ( .A(pixel9[5]), .Y(n232) );
  INVX4 U148 ( .A(pixel9[6]), .Y(n231) );
  INVX4 U149 ( .A(pixel9[3]), .Y(n234) );
  INVX4 U150 ( .A(pixel9[2]), .Y(n235) );
  INVX4 U151 ( .A(pixel9[7]), .Y(n230) );
  BUFX2 U152 ( .A(n45), .Y(n12) );
  NAND2XL U153 ( .A(n220), .B(n48), .Y(n45) );
  NAND2X2 U154 ( .A(n32), .B(n48), .Y(n36) );
  NOR2BX2 U155 ( .AN(n49), .B(n25), .Y(n48) );
  AOI22X1 U156 ( .A0(valid_r), .A1(n201), .B0(n200), .B1(n564), .Y(n204) );
  NAND2X2 U157 ( .A(n62), .B(n31), .Y(n64) );
  NAND2X2 U158 ( .A(n223), .B(n62), .Y(n57) );
  NAND2X2 U159 ( .A(n220), .B(n62), .Y(n174) );
  NAND2X2 U160 ( .A(n545), .B(n62), .Y(n179) );
  NAND2X2 U161 ( .A(n541), .B(n62), .Y(n59) );
  NAND2X2 U162 ( .A(n32), .B(n62), .Y(n176) );
  NOR2X2 U163 ( .A(n53), .B(n52), .Y(n62) );
  NOR2XL U164 ( .A(n210), .B(n688), .Y(n15) );
  NAND2X2 U165 ( .A(n32), .B(n226), .Y(n227) );
  NAND2X2 U166 ( .A(n223), .B(n226), .Y(n224) );
  NAND2X2 U167 ( .A(n220), .B(n226), .Y(n221) );
  NAND2X2 U168 ( .A(n541), .B(n226), .Y(n218) );
  NAND2X2 U169 ( .A(n545), .B(n226), .Y(n216) );
  NAND2X2 U170 ( .A(n31), .B(n226), .Y(n214) );
  NAND2X2 U171 ( .A(n211), .B(n226), .Y(n212) );
  NOR2X2 U172 ( .A(n17), .B(n47), .Y(n239) );
  AOI211XL U173 ( .A0(n32), .A1(\col2_r[4][1] ), .B0(n297), .C0(n296), .Y(n298) );
  AOI211XL U174 ( .A0(n32), .A1(\col2_r[4][4] ), .B0(n329), .C0(n328), .Y(n330) );
  AOI211XL U175 ( .A0(n32), .A1(\col2_r[4][7] ), .B0(n362), .C0(n361), .Y(n363) );
  NOR3XL U176 ( .A(n447), .B(n446), .C(n445), .Y(n448) );
  INVXL U177 ( .A(n65), .Y(n66) );
  NOR2XL U178 ( .A(n628), .B(n3), .Y(n246) );
  NOR2XL U179 ( .A(n603), .B(n3), .Y(n269) );
  NOR2XL U180 ( .A(n602), .B(n3), .Y(n284) );
  OR4X2 U181 ( .A(n367), .B(n366), .C(n365), .D(n364), .Y(n373) );
  OR4X2 U182 ( .A(n476), .B(n475), .C(n474), .D(n473), .Y(n482) );
  AOI211XL U183 ( .A0(RGB_data[2]), .A1(n67), .B0(n75), .C0(n74), .Y(n78) );
  AOI22XL U184 ( .A0(n65), .A1(\intadd_7/SUM[6] ), .B0(ver_sum_r[7]), .B1(n71), 
        .Y(n110) );
  NOR4XL U185 ( .A(n254), .B(n253), .C(n252), .D(n251), .Y(n255) );
  OAI211XL U186 ( .A0(n774), .A1(n133), .B0(n82), .C0(n81), .Y(n1016) );
  OAI211XL U187 ( .A0(n771), .A1(n99), .B0(n124), .C0(n123), .Y(n1030) );
  CLKBUFX3 U188 ( .A(rst_n), .Y(n778) );
  OAI2BB2XL U189 ( .B0(\intadd_9/n1 ), .B1(n248), .A0N(up_sum_r[8]), .A1N(n407), .Y(n1046) );
  OAI2BB2XL U190 ( .B0(n620), .B1(n248), .A0N(col_last_buf_r), .A1N(n407), .Y(
        n1093) );
  NOR2X1 U191 ( .A(state_r[2]), .B(n692), .Y(n195) );
  NOR2XL U192 ( .A(n618), .B(n566), .Y(n18) );
  NAND2X1 U193 ( .A(counter_r[0]), .B(counter_r[1]), .Y(n205) );
  NOR2X1 U194 ( .A(n574), .B(n205), .Y(n569) );
  NOR2XL U195 ( .A(n26), .B(n688), .Y(n182) );
  OAI21XL U196 ( .A0(n195), .A1(n18), .B0(n182), .Y(n19) );
  NOR2XL U197 ( .A(n569), .B(end_col_r), .Y(n198) );
  INVX1 U198 ( .A(n198), .Y(n188) );
  NAND2XL U199 ( .A(valid_r), .B(n195), .Y(n194) );
  NOR2XL U200 ( .A(n188), .B(n194), .Y(n200) );
  AOI22XL U201 ( .A0(state_r[1]), .A1(n19), .B0(n200), .B1(n192), .Y(n21) );
  NAND4XL U202 ( .A(state_r[0]), .B(n569), .C(valid_r), .D(n23), .Y(n20) );
  OAI211XL U203 ( .A0(state_r[2]), .A1(n564), .B0(n21), .C0(n20), .Y(
        state_w[1]) );
  NOR3X1 U204 ( .A(counter_r[1]), .B(n689), .C(n574), .Y(n223) );
  CLKINVX1 U205 ( .A(n23), .Y(n181) );
  NOR2X1 U206 ( .A(n566), .B(n690), .Y(n571) );
  OAI22X1 U207 ( .A0(n185), .A1(n195), .B0(n564), .B1(n571), .Y(n209) );
  OAI22X1 U208 ( .A0(n185), .A1(n571), .B0(n564), .B1(n23), .Y(n210) );
  NOR2X2 U209 ( .A(n181), .B(n192), .Y(n61) );
  NAND3X1 U210 ( .A(n51), .B(valid_r), .C(n52), .Y(n25) );
  NOR3X4 U211 ( .A(n209), .B(n188), .C(n25), .Y(n60) );
  OAI21XL U212 ( .A0(n185), .A1(state_r[2]), .B0(n566), .Y(n186) );
  OR2X2 U213 ( .A(n25), .B(n202), .Y(n47) );
  AOI211X2 U214 ( .A0(n49), .A1(n540), .B0(n60), .C0(n47), .Y(n37) );
  OAI222XL U215 ( .A0(n11), .A1(n233), .B0(n610), .B1(n37), .C0(n5), .C1(n725), 
        .Y(n1135) );
  OAI222XL U216 ( .A0(n11), .A1(n240), .B0(n622), .B1(n37), .C0(n5), .C1(n695), 
        .Y(n1127) );
  NOR3X1 U217 ( .A(counter_r[0]), .B(counter_r[1]), .C(n574), .Y(n220) );
  CLKINVX1 U218 ( .A(n220), .Y(n134) );
  AOI211X2 U219 ( .A0(n49), .A1(n547), .B0(n60), .C0(n47), .Y(n46) );
  OAI222XL U220 ( .A0(n12), .A1(n236), .B0(n718), .B1(n46), .C0(n5), .C1(n632), 
        .Y(n1145) );
  OAI222XL U221 ( .A0(n12), .A1(n232), .B0(n747), .B1(n46), .C0(n5), .C1(n607), 
        .Y(n1153) );
  NOR2XL U222 ( .A(counter_r[0]), .B(counter_r[1]), .Y(n28) );
  INVX1 U223 ( .A(n29), .Y(n211) );
  AOI211X2 U224 ( .A0(n49), .A1(n29), .B0(n60), .C0(n47), .Y(n43) );
  OAI222XL U225 ( .A0(n44), .A1(n230), .B0(n665), .B1(n43), .C0(n602), .C1(n5), 
        .Y(n1221) );
  OAI222XL U226 ( .A0(n231), .A1(n44), .B0(n664), .B1(n43), .C0(n605), .C1(n5), 
        .Y(n1219) );
  OAI222XL U227 ( .A0(n233), .A1(n44), .B0(n662), .B1(n43), .C0(n603), .C1(n5), 
        .Y(n1215) );
  OAI222XL U228 ( .A0(n234), .A1(n44), .B0(n741), .B1(n43), .C0(n657), .C1(n5), 
        .Y(n1213) );
  OAI222XL U229 ( .A0(n232), .A1(n44), .B0(n663), .B1(n43), .C0(n604), .C1(n5), 
        .Y(n1217) );
  OAI222XL U230 ( .A0(n235), .A1(n44), .B0(n638), .B1(n43), .C0(n590), .C1(n5), 
        .Y(n1211) );
  NOR3X2 U231 ( .A(counter_r[2]), .B(counter_r[0]), .C(n619), .Y(n545) );
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
        .Y(n1172) );
  AOI211X2 U336 ( .A0(n61), .A1(n3), .B0(n60), .C0(n229), .Y(n63) );
  OAI222XL U337 ( .A0(n675), .A1(n1), .B0(n729), .B1(n63), .C0(n230), .C1(n64), 
        .Y(n1206) );
  OAI222XL U338 ( .A0(n64), .A1(n240), .B0(n588), .B1(n63), .C0(n714), .C1(n1), 
        .Y(n1192) );
  OAI222XL U339 ( .A0(n64), .A1(n235), .B0(n699), .B1(n63), .C0(n177), .C1(
        n639), .Y(n1196) );
  OAI222XL U340 ( .A0(n64), .A1(n231), .B0(n732), .B1(n63), .C0(n5), .C1(n672), 
        .Y(n1204) );
  OAI222XL U341 ( .A0(n64), .A1(n234), .B0(n700), .B1(n63), .C0(n177), .C1(
        n596), .Y(n1198) );
  OAI222XL U342 ( .A0(n64), .A1(n236), .B0(n589), .B1(n63), .C0(n713), .C1(n5), 
        .Y(n1194) );
  OAI222XL U343 ( .A0(n64), .A1(n233), .B0(n730), .B1(n63), .C0(n177), .C1(
        n666), .Y(n1200) );
  OAI222XL U344 ( .A0(n64), .A1(n232), .B0(n731), .B1(n63), .C0(n177), .C1(
        n669), .Y(n1202) );
  BUFX2 U345 ( .A(n66), .Y(n133) );
  NAND2X1 U346 ( .A(logic_state_r[0]), .B(logic_state_r[2]), .Y(n561) );
  NAND3X1 U347 ( .A(n635), .B(n722), .C(n16), .Y(n560) );
  INVXL U348 ( .A(n68), .Y(n70) );
  NAND3XL U349 ( .A(logic_state_r[2]), .B(logic_state_r[1]), .C(n635), .Y(n250) );
  NOR2XL U350 ( .A(logic_state_r[1]), .B(n561), .Y(n76) );
  BUFX2 U351 ( .A(n76), .Y(n563) );
  NAND2XL U352 ( .A(n563), .B(G_data_r[2]), .Y(n77) );
  OAI211XL U353 ( .A0(n772), .A1(n133), .B0(n78), .C0(n77), .Y(n1018) );
  AOI211XL U354 ( .A0(RGB_data[0]), .A1(n67), .B0(n80), .C0(n79), .Y(n82) );
  NAND2XL U355 ( .A(n563), .B(G_data_r[0]), .Y(n81) );
  AOI211XL U356 ( .A0(RGB_data[3]), .A1(n67), .B0(n84), .C0(n83), .Y(n86) );
  NAND2XL U357 ( .A(n563), .B(G_data_r[3]), .Y(n85) );
  OAI211XL U358 ( .A0(n771), .A1(n133), .B0(n86), .C0(n85), .Y(n1019) );
  AOI211XL U359 ( .A0(RGB_data[1]), .A1(n67), .B0(n88), .C0(n87), .Y(n90) );
  NAND2XL U360 ( .A(n563), .B(G_data_r[1]), .Y(n89) );
  OAI211XL U361 ( .A0(n773), .A1(n133), .B0(n90), .C0(n89), .Y(n1017) );
  AOI211XL U362 ( .A0(RGB_data[4]), .A1(n67), .B0(n92), .C0(n91), .Y(n94) );
  NAND2XL U363 ( .A(n563), .B(G_data_r[4]), .Y(n93) );
  OAI211XL U364 ( .A0(n770), .A1(n133), .B0(n94), .C0(n93), .Y(n1020) );
  AOI211XL U365 ( .A0(RGB_data[5]), .A1(n67), .B0(n96), .C0(n95), .Y(n98) );
  NAND2XL U366 ( .A(n563), .B(G_data_r[5]), .Y(n97) );
  OAI211XL U367 ( .A0(n769), .A1(n133), .B0(n98), .C0(n97), .Y(n1021) );
  NAND2BX4 U368 ( .AN(n247), .B(n561), .Y(n193) );
  AOI222XL U369 ( .A0(n193), .A1(G_data_r[7]), .B0(cen_r[7]), .B1(n68), .C0(
        n100), .C1(\intadd_8/n1 ), .Y(n101) );
  INVXL U370 ( .A(n101), .Y(n1042) );
  AOI222XL U371 ( .A0(n100), .A1(\intadd_8/SUM[6] ), .B0(cen_r[6]), .B1(n68), 
        .C0(n193), .C1(G_data_r[6]), .Y(n102) );
  INVXL U372 ( .A(n102), .Y(n1041) );
  AOI222XL U373 ( .A0(n100), .A1(\intadd_8/SUM[3] ), .B0(cen_r[3]), .B1(n68), 
        .C0(n193), .C1(G_data_r[3]), .Y(n103) );
  INVXL U374 ( .A(n103), .Y(n1038) );
  AOI222XL U375 ( .A0(n100), .A1(\intadd_8/SUM[4] ), .B0(cen_r[4]), .B1(n68), 
        .C0(n193), .C1(G_data_r[4]), .Y(n104) );
  INVXL U376 ( .A(n104), .Y(n1039) );
  AOI222XL U377 ( .A0(n100), .A1(\intadd_8/SUM[2] ), .B0(cen_r[2]), .B1(n68), 
        .C0(n193), .C1(G_data_r[2]), .Y(n105) );
  INVXL U378 ( .A(n105), .Y(n1037) );
  AOI222XL U379 ( .A0(n100), .A1(\intadd_8/SUM[5] ), .B0(cen_r[5]), .B1(n68), 
        .C0(n193), .C1(G_data_r[5]), .Y(n106) );
  INVXL U380 ( .A(n106), .Y(n1040) );
  AOI222XL U381 ( .A0(n100), .A1(\intadd_8/SUM[1] ), .B0(cen_r[1]), .B1(n68), 
        .C0(n193), .C1(G_data_r[1]), .Y(n107) );
  INVXL U382 ( .A(n107), .Y(n1036) );
  AOI222XL U383 ( .A0(n100), .A1(\intadd_8/SUM[0] ), .B0(cen_r[0]), .B1(n68), 
        .C0(n193), .C1(G_data_r[0]), .Y(n108) );
  INVXL U384 ( .A(n108), .Y(n1035) );
  AOI22XL U385 ( .A0(hor_sum_r[7]), .A1(n69), .B0(B_data_r[6]), .B1(n193), .Y(
        n109) );
  OAI211XL U386 ( .A0(n768), .A1(n99), .B0(n110), .C0(n109), .Y(n1033) );
  AOI22XL U387 ( .A0(n65), .A1(\intadd_7/SUM[4] ), .B0(ver_sum_r[5]), .B1(n71), 
        .Y(n112) );
  AOI22XL U388 ( .A0(hor_sum_r[5]), .A1(n69), .B0(B_data_r[4]), .B1(n193), .Y(
        n111) );
  OAI211XL U389 ( .A0(n770), .A1(n99), .B0(n112), .C0(n111), .Y(n1031) );
  AOI22XL U390 ( .A0(n65), .A1(\intadd_7/SUM[5] ), .B0(ver_sum_r[6]), .B1(n71), 
        .Y(n114) );
  AOI22XL U391 ( .A0(hor_sum_r[6]), .A1(n69), .B0(B_data_r[5]), .B1(n193), .Y(
        n113) );
  OAI211XL U392 ( .A0(n769), .A1(n99), .B0(n114), .C0(n113), .Y(n1032) );
  AOI22XL U393 ( .A0(n65), .A1(\intadd_7/SUM[0] ), .B0(ver_sum_r[1]), .B1(n71), 
        .Y(n116) );
  AOI22XL U394 ( .A0(hor_sum_r[1]), .A1(n69), .B0(B_data_r[0]), .B1(n193), .Y(
        n115) );
  OAI211XL U395 ( .A0(n774), .A1(n99), .B0(n116), .C0(n115), .Y(n1027) );
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
  OAI22XL U451 ( .A0(n17), .A1(n613), .B0(n547), .B1(n583), .Y(n169) );
  OAI22XL U452 ( .A0(n30), .A1(n665), .B0(n498), .B1(n749), .Y(n168) );
  NOR3XL U453 ( .A(n170), .B(n169), .C(n168), .Y(\intadd_9/A[5] ) );
  OAI2BB1X1 U454 ( .A0N(n560), .A1N(RGB_valid), .B0(n67), .Y(RGB_valid_w) );
  OAI211XL U455 ( .A0(ver_sum_r[1]), .A1(hor_sum_r[1]), .B0(ver_sum_r[0]), 
        .C0(hor_sum_r[0]), .Y(n171) );
  OAI2BB1X1 U456 ( .A0N(hor_sum_r[1]), .A1N(ver_sum_r[1]), .B0(n171), .Y(
        \intadd_8/CI ) );
  OAI211XL U457 ( .A0(up_sum_r[1]), .A1(down_sum_r[1]), .B0(up_sum_r[0]), .C0(
        down_sum_r[0]), .Y(n172) );
  OAI2BB1X1 U458 ( .A0N(down_sum_r[1]), .A1N(up_sum_r[1]), .B0(n172), .Y(
        \intadd_7/CI ) );
  OAI222XL U459 ( .A0(n758), .A1(n177), .B0(n661), .B1(n175), .C0(n230), .C1(
        n176), .Y(n1126) );
  OAI222XL U460 ( .A0(n176), .A1(n231), .B0(n660), .B1(n175), .C0(n177), .C1(
        n755), .Y(n1124) );
  OAI222XL U461 ( .A0(n174), .A1(n233), .B0(n606), .B1(n173), .C0(n177), .C1(
        n668), .Y(n1152) );
  OAI222XL U462 ( .A0(n176), .A1(n232), .B0(n659), .B1(n175), .C0(n177), .C1(
        n756), .Y(n1122) );
  OAI222XL U463 ( .A0(n179), .A1(n231), .B0(n600), .B1(n178), .C0(n177), .C1(
        n744), .Y(n1188) );
  BUFX4 U464 ( .A(rst_n), .Y(n777) );
  NAND2XL U465 ( .A(state_r[0]), .B(n17), .Y(n565) );
  NAND4XL U466 ( .A(n566), .B(n691), .C(n620), .D(n565), .Y(n180) );
  OAI31XL U467 ( .A0(n181), .A1(n564), .A2(n3), .B0(n180), .Y(n184) );
  OAI211XL U468 ( .A0(n185), .A1(n31), .B0(n182), .C0(n692), .Y(n183) );
  OAI22XL U469 ( .A0(n185), .A1(n31), .B0(n564), .B1(n198), .Y(n187) );
  OAI21XL U470 ( .A0(n690), .A1(n187), .B0(n186), .Y(n191) );
  NOR2XL U471 ( .A(state_r[0]), .B(state_r[1]), .Y(n189) );
  OAI21XL U472 ( .A0(n189), .A1(n188), .B0(valid_r), .Y(n190) );
  OAI21XL U473 ( .A0(n194), .A1(n192), .B0(n247), .Y(n1284) );
  INVX1 U474 ( .A(n193), .Y(n558) );
  OAI31XL U475 ( .A0(state_r[1]), .A1(n194), .A2(n558), .B0(n561), .Y(n1283)
         );
  OAI221XL U476 ( .A0(state_r[1]), .A1(n195), .B0(n691), .B1(n571), .C0(
        state_r[0]), .Y(n197) );
  AOI21XL U477 ( .A0(logic_state_r[0]), .A1(logic_state_r[1]), .B0(n558), .Y(
        n196) );
  OAI31XL U478 ( .A0(n563), .A1(n197), .A2(n688), .B0(n196), .Y(n1282) );
  OAI32XL U479 ( .A0(n618), .A1(n198), .A2(n691), .B0(state_r[1]), .B1(
        state_r[0]), .Y(n199) );
  OAI21XL U480 ( .A0(n566), .A1(n199), .B0(n210), .Y(n201) );
  NOR2XL U481 ( .A(n688), .B(n202), .Y(n208) );
  OAI22XL U482 ( .A0(counter_r[0]), .A1(n204), .B0(n689), .B1(n208), .Y(n1281)
         );
  OAI22XL U483 ( .A0(n203), .A1(n204), .B0(n574), .B1(n208), .Y(n1280) );
  INVXL U484 ( .A(n204), .Y(n206) );
  OAI211XL U485 ( .A0(counter_r[0]), .A1(counter_r[1]), .B0(n206), .C0(n205), 
        .Y(n207) );
  OAI21XL U486 ( .A0(n208), .A1(n619), .B0(n207), .Y(n1279) );
  OAI22XL U487 ( .A0(n213), .A1(n740), .B0(n230), .B1(n212), .Y(n1278) );
  OAI22XL U488 ( .A0(n213), .A1(n739), .B0(n231), .B1(n212), .Y(n1277) );
  OAI22XL U489 ( .A0(n213), .A1(n738), .B0(n232), .B1(n212), .Y(n1276) );
  OAI22XL U490 ( .A0(n213), .A1(n737), .B0(n233), .B1(n212), .Y(n1275) );
  OAI22XL U491 ( .A0(n213), .A1(n736), .B0(n234), .B1(n212), .Y(n1274) );
  OAI22XL U492 ( .A0(n213), .A1(n735), .B0(n235), .B1(n212), .Y(n1273) );
  OAI22XL U493 ( .A0(n213), .A1(n754), .B0(n236), .B1(n212), .Y(n1272) );
  OAI22XL U494 ( .A0(n213), .A1(n711), .B0(n240), .B1(n212), .Y(n1271) );
  OAI22XL U495 ( .A0(n215), .A1(n675), .B0(n230), .B1(n214), .Y(n1270) );
  OAI22XL U496 ( .A0(n215), .A1(n672), .B0(n231), .B1(n214), .Y(n1269) );
  OAI22XL U497 ( .A0(n215), .A1(n669), .B0(n232), .B1(n214), .Y(n1268) );
  OAI22XL U498 ( .A0(n215), .A1(n666), .B0(n233), .B1(n214), .Y(n1267) );
  OAI22XL U499 ( .A0(n215), .A1(n596), .B0(n234), .B1(n214), .Y(n1266) );
  OAI22XL U500 ( .A0(n215), .A1(n639), .B0(n235), .B1(n214), .Y(n1265) );
  OAI22XL U501 ( .A0(n215), .A1(n713), .B0(n236), .B1(n214), .Y(n1264) );
  OAI22XL U502 ( .A0(n215), .A1(n714), .B0(n240), .B1(n214), .Y(n1263) );
  OAI22XL U503 ( .A0(n217), .A1(n745), .B0(n230), .B1(n216), .Y(n1262) );
  OAI22XL U504 ( .A0(n217), .A1(n744), .B0(n231), .B1(n216), .Y(n1261) );
  OAI22XL U505 ( .A0(n217), .A1(n743), .B0(n232), .B1(n216), .Y(n1260) );
  OAI22XL U506 ( .A0(n217), .A1(n742), .B0(n233), .B1(n216), .Y(n1259) );
  OAI22XL U507 ( .A0(n217), .A1(n642), .B0(n234), .B1(n216), .Y(n1258) );
  OAI22XL U508 ( .A0(n217), .A1(n703), .B0(n235), .B1(n216), .Y(n1257) );
  OAI22XL U509 ( .A0(n217), .A1(n592), .B0(n236), .B1(n216), .Y(n1256) );
  OAI22XL U510 ( .A0(n217), .A1(n584), .B0(n240), .B1(n216), .Y(n1255) );
  OAI22XL U511 ( .A0(n219), .A1(n753), .B0(n230), .B1(n218), .Y(n1254) );
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
  OR4X2 U782 ( .A(n502), .B(n501), .C(n500), .D(n499), .Y(n511) );
  ADDFX1 U783 ( .A(n504), .B(pixel9[3]), .CI(n503), .CO(n510), .S(n497) );
  OAI22XL U784 ( .A0(n540), .A1(n611), .B0(n29), .B1(n663), .Y(n509) );
  OAI22XL U785 ( .A0(n6), .A1(n615), .B0(n547), .B1(n747), .Y(n508) );
  OAI22XL U786 ( .A0(n30), .A1(n581), .B0(n2), .B1(n761), .Y(n507) );
  OAI22XL U787 ( .A0(n17), .A1(n763), .B0(n3), .B1(n679), .Y(n506) );
  OR4X2 U788 ( .A(n509), .B(n508), .C(n507), .D(n506), .Y(n518) );
  ADDFX1 U789 ( .A(n511), .B(pixel9[4]), .CI(n510), .CO(n517), .S(n505) );
  OAI22XL U790 ( .A0(n540), .A1(n612), .B0(n29), .B1(n664), .Y(n516) );
  OAI22XL U791 ( .A0(n6), .A1(n616), .B0(n547), .B1(n748), .Y(n515) );
  OAI22XL U792 ( .A0(n30), .A1(n582), .B0(n2), .B1(n760), .Y(n514) );
  OAI22XL U793 ( .A0(n17), .A1(n776), .B0(n3), .B1(n680), .Y(n513) );
  OR4X2 U794 ( .A(n516), .B(n515), .C(n514), .D(n513), .Y(n526) );
  ADDFX1 U795 ( .A(n518), .B(pixel9[5]), .CI(n517), .CO(n525), .S(n512) );
  OAI22XL U796 ( .A0(n540), .A1(n613), .B0(n29), .B1(n665), .Y(n524) );
  OAI22XL U797 ( .A0(n546), .A1(n617), .B0(n547), .B1(n749), .Y(n523) );
  OAI22XL U798 ( .A0(n30), .A1(n583), .B0(n2), .B1(n759), .Y(n522) );
  OAI22XL U799 ( .A0(n17), .A1(n775), .B0(n3), .B1(n681), .Y(n521) );
  OR4X2 U800 ( .A(n524), .B(n523), .C(n522), .D(n521), .Y(n529) );
  ADDFX1 U801 ( .A(n526), .B(pixel9[6]), .CI(n525), .CO(n528), .S(n519) );
  ADDFX1 U802 ( .A(n529), .B(pixel9[7]), .CI(n528), .CO(n530), .S(n527) );
  OAI22XL U803 ( .A0(n17), .A1(n621), .B0(n547), .B1(n584), .Y(n533) );
  OAI21XL U804 ( .A0(n2), .A1(n623), .B0(n531), .Y(n532) );
  AOI211XL U805 ( .A0(n545), .A1(\col3_r[0][0] ), .B0(n533), .C0(n532), .Y(
        n538) );
  OAI22XL U806 ( .A0(n17), .A1(n622), .B0(n547), .B1(n585), .Y(n536) );
  OAI21XL U807 ( .A0(n2), .A1(n624), .B0(n534), .Y(n535) );
  AOI211XL U808 ( .A0(n545), .A1(\col1_r[0][0] ), .B0(n536), .C0(n535), .Y(
        n537) );
  NOR2X1 U809 ( .A(n538), .B(n537), .Y(n556) );
  AOI211XL U810 ( .A0(n538), .A1(n537), .B0(n556), .C0(n248), .Y(n539) );
  OAI22XL U811 ( .A0(n17), .A1(n636), .B0(n547), .B1(n592), .Y(n544) );
  OAI21XL U812 ( .A0(n2), .A1(n705), .B0(n542), .Y(n543) );
  AOI211X1 U813 ( .A0(n545), .A1(\col3_r[0][1] ), .B0(n544), .C0(n543), .Y(
        n553) );
  OAI22XL U814 ( .A0(n546), .A1(n579), .B0(n540), .B1(n644), .Y(n549) );
  OAI22XL U815 ( .A0(n17), .A1(n637), .B0(n547), .B1(n593), .Y(n548) );
  AOI211XL U816 ( .A0(n32), .A1(\col1_r[4][1] ), .B0(n549), .C0(n548), .Y(n550) );
  OAI21X1 U817 ( .A0(n30), .A1(n708), .B0(n550), .Y(n554) );
  OAI2BB2XL U818 ( .B0(n248), .B1(n552), .A0N(n407), .A1N(up_sum_r[1]), .Y(
        n1053) );
  INVXL U819 ( .A(n553), .Y(n555) );
  AOI222XL U820 ( .A0(n556), .A1(n555), .B0(n556), .B1(n554), .C0(n555), .C1(
        n554), .Y(\intadd_9/A[0] ) );
  OAI2BB2XL U821 ( .B0(\intadd_9/SUM[0] ), .B1(n248), .A0N(up_sum_r[2]), .A1N(
        n407), .Y(n1052) );
  OAI2BB2XL U822 ( .B0(\intadd_9/SUM[1] ), .B1(n248), .A0N(up_sum_r[3]), .A1N(
        n407), .Y(n1051) );
  OAI2BB2XL U823 ( .B0(\intadd_9/SUM[2] ), .B1(n248), .A0N(up_sum_r[4]), .A1N(
        n407), .Y(n1050) );
  OAI2BB2XL U824 ( .B0(\intadd_9/SUM[3] ), .B1(n248), .A0N(up_sum_r[5]), .A1N(
        n407), .Y(n1049) );
  OAI2BB2XL U825 ( .B0(\intadd_9/SUM[4] ), .B1(n248), .A0N(up_sum_r[6]), .A1N(
        n407), .Y(n1048) );
  OAI2BB2XL U826 ( .B0(\intadd_9/SUM[5] ), .B1(n248), .A0N(up_sum_r[7]), .A1N(
        n407), .Y(n1047) );
  OAI21XL U827 ( .A0(n16), .A1(n722), .B0(n560), .Y(n559) );
  OAI2BB1X1 U828 ( .A0N(n561), .A1N(n560), .B0(color[0]), .Y(n562) );
  NAND2XL U829 ( .A(n564), .B(n690), .Y(n568) );
  AOI32XL U830 ( .A0(state_r[0]), .A1(n566), .A2(n620), .B0(n565), .B1(n692), 
        .Y(n567) );
  AOI211XL U831 ( .A0(state_r[1]), .A1(n569), .B0(n568), .C0(n567), .Y(n570)
         );
  AOI31XL U832 ( .A0(state_r[1]), .A1(n571), .A2(n620), .B0(n570), .Y(n573) );
  OAI21XL U833 ( .A0(n688), .A1(state_r[2]), .B0(n618), .Y(n572) );
  OAI21XL U834 ( .A0(n573), .A1(n688), .B0(n572), .Y(n1024) );
endmodule


module gamma_122 ( clk, rst_n, pixel_in, valid_in, color_in, last_pic_in, 
        pixel_out, valid_out, color_out, last_pic_out );
  input [7:0] pixel_in;
  input [1:0] color_in;
  output [7:0] pixel_out;
  output [1:0] color_out;
  input clk, rst_n, valid_in, last_pic_in;
  output valid_out, last_pic_out;
  wire   n_valid_out_reg, n_last_pic_out_reg, n240, n241, n242, n243, n244,
         n245, n246, n247, n248, n2, n4, n5, n6, n7, n8, n9, n10, n11, n12,
         n13, n14, n15, n16, n17, n18, n19, n20, n21, n22, n23, n24, n25, n26,
         n27, n28, n29, n30, n31, n32, n33, n34, n35, n36, n37, n38, n39, n40,
         n41, n42, n43, n44, n45, n46, n47, n48, n49, n50, n51, n52, n53, n54,
         n55, n56, n57, n58, n59, n60, n61, n62, n63, n64, n65, n66, n67, n68,
         n69, n70, n71, n72, n73, n74, n75, n76, n77, n78, n79, n80, n81, n82,
         n83, n84, n85, n86, n87, n88, n89, n90, n91, n92, n93, n94, n95, n96,
         n97, n98, n99, n100, n101, n102, n103, n104, n105, n106, n107, n108,
         n109, n110, n111, n112, n113, n114, n115, n116, n117, n118, n119,
         n120, n121, n122, n123, n124, n125, n126, n127, n128, n129, n130,
         n131, n132, n133, n134, n135, n136, n137, n138, n139, n140, n141,
         n142, n143, n144, n145, n146, n147, n148, n149, n150, n151, n152,
         n153, n154, n155, n156, n157, n158, n159, n160, n161, n162, n163,
         n164, n165, n166, n167, n168, n169, n170, n171, n172, n173, n174,
         n175, n176, n177, n178, n179, n180, n181, n182, n183, n184, n185,
         n186, n187, n188, n189, n190, n191, n192, n193, n194, n195, n196,
         n197, n198, n199, n200, n201, n202, n203, n204, n205, n206, n207,
         n208, n209, n210, n211, n212, n213, n214, n215, n216, n217, n218,
         n219, n220;
  wire   [1:0] n_color_out_reg;
  wire   [7:0] pixel_in_reg;
  wire   [7:0] n_pixel_out_reg;

  DFFRX1 \pixel_in_reg_reg[7]  ( .D(pixel_in[7]), .CK(clk), .RN(rst_n), .Q(
        pixel_in_reg[7]), .QN(n5) );
  DFFRX1 \pixel_in_reg_reg[6]  ( .D(pixel_in[6]), .CK(clk), .RN(rst_n), .Q(
        pixel_in_reg[6]) );
  DFFRX1 \pixel_in_reg_reg[5]  ( .D(pixel_in[5]), .CK(clk), .RN(rst_n), .Q(
        pixel_in_reg[5]), .QN(n218) );
  DFFRX1 \pixel_in_reg_reg[3]  ( .D(pixel_in[3]), .CK(clk), .RN(rst_n), .Q(
        pixel_in_reg[3]), .QN(n219) );
  DFFRX1 \pixel_in_reg_reg[2]  ( .D(pixel_in[2]), .CK(clk), .RN(rst_n), .Q(
        pixel_in_reg[2]), .QN(n220) );
  DFFRX1 valid_in_reg_reg ( .D(valid_in), .CK(clk), .RN(rst_n), .Q(
        n_valid_out_reg) );
  DFFRX1 \color_in_reg_reg[1]  ( .D(color_in[1]), .CK(clk), .RN(rst_n), .Q(
        n_color_out_reg[1]) );
  DFFRX1 \color_out_reg_reg[1]  ( .D(n_color_out_reg[1]), .CK(clk), .RN(rst_n), 
        .Q(color_out[1]) );
  DFFRX1 \color_in_reg_reg[0]  ( .D(color_in[0]), .CK(clk), .RN(rst_n), .Q(
        n_color_out_reg[0]) );
  DFFRX1 \color_out_reg_reg[0]  ( .D(n_color_out_reg[0]), .CK(clk), .RN(rst_n), 
        .Q(color_out[0]) );
  DFFRX1 last_pic_in_reg_reg ( .D(last_pic_in), .CK(clk), .RN(rst_n), .Q(
        n_last_pic_out_reg) );
  DFFRX1 last_pic_out_reg_reg ( .D(n_last_pic_out_reg), .CK(clk), .RN(rst_n), 
        .Q(last_pic_out) );
  DFFRX1 \pixel_out_reg_reg[7]  ( .D(n_pixel_out_reg[7]), .CK(clk), .RN(rst_n), 
        .Q(pixel_out[7]) );
  DFFRX1 \pixel_out_reg_reg[6]  ( .D(n_pixel_out_reg[6]), .CK(clk), .RN(rst_n), 
        .Q(pixel_out[6]) );
  DFFRX1 \pixel_out_reg_reg[5]  ( .D(n_pixel_out_reg[5]), .CK(clk), .RN(rst_n), 
        .Q(pixel_out[5]) );
  DFFRX1 \pixel_out_reg_reg[4]  ( .D(n_pixel_out_reg[4]), .CK(clk), .RN(rst_n), 
        .Q(pixel_out[4]) );
  DFFRX1 \pixel_out_reg_reg[3]  ( .D(n_pixel_out_reg[3]), .CK(clk), .RN(rst_n), 
        .Q(pixel_out[3]) );
  DFFRX1 \pixel_out_reg_reg[2]  ( .D(n_pixel_out_reg[2]), .CK(clk), .RN(rst_n), 
        .Q(pixel_out[2]) );
  DFFRX1 \pixel_out_reg_reg[1]  ( .D(n_pixel_out_reg[1]), .CK(clk), .RN(rst_n), 
        .Q(pixel_out[1]) );
  DFFRX1 \pixel_out_reg_reg[0]  ( .D(n_pixel_out_reg[0]), .CK(clk), .RN(rst_n), 
        .Q(pixel_out[0]) );
  DFFRX1 valid_out_reg_reg ( .D(n_valid_out_reg), .CK(clk), .RN(rst_n), .Q(
        valid_out) );
  TLATX1 \n_pixel_out_reg_reg[0]  ( .G(n248), .D(n246), .Q(n_pixel_out_reg[0])
         );
  TLATX1 \n_pixel_out_reg_reg[4]  ( .G(n248), .D(n242), .Q(n_pixel_out_reg[4])
         );
  DFFRX2 \pixel_in_reg_reg[4]  ( .D(pixel_in[4]), .CK(clk), .RN(rst_n), .Q(
        pixel_in_reg[4]), .QN(n217) );
  DFFRX2 \pixel_in_reg_reg[0]  ( .D(pixel_in[0]), .CK(clk), .RN(rst_n), .Q(
        pixel_in_reg[0]) );
  DFFRX1 \pixel_in_reg_reg[1]  ( .D(pixel_in[1]), .CK(clk), .RN(rst_n), .Q(
        pixel_in_reg[1]) );
  TLATX1 \n_pixel_out_reg_reg[5]  ( .G(n248), .D(n241), .Q(n_pixel_out_reg[5])
         );
  TLATX1 \n_pixel_out_reg_reg[6]  ( .G(n248), .D(n240), .Q(n_pixel_out_reg[6])
         );
  TLATX1 \n_pixel_out_reg_reg[2]  ( .G(n248), .D(n244), .Q(n_pixel_out_reg[2])
         );
  TLATX1 \n_pixel_out_reg_reg[1]  ( .G(n248), .D(n245), .Q(n_pixel_out_reg[1])
         );
  TLATX1 \n_pixel_out_reg_reg[3]  ( .G(n248), .D(n243), .Q(n_pixel_out_reg[3])
         );
  TLATX1 \n_pixel_out_reg_reg[7]  ( .G(n248), .D(n247), .Q(n_pixel_out_reg[7])
         );
  AOI2BB2X1 U3 ( .B0(n182), .B1(n157), .A0N(n156), .A1N(n155), .Y(n161) );
  AOI2BB2X2 U4 ( .B0(pixel_in_reg[7]), .B1(n116), .A0N(n115), .A1N(n207), .Y(
        n122) );
  CLKINVX2 U5 ( .A(n78), .Y(n7) );
  NOR4BX1 U6 ( .AN(n111), .B(n110), .C(n109), .D(n165), .Y(n146) );
  INVX2 U7 ( .A(n168), .Y(n12) );
  INVX1 U8 ( .A(n94), .Y(n72) );
  NAND3BX1 U9 ( .AN(n204), .B(n137), .C(n47), .Y(n214) );
  AO21X2 U10 ( .A0(n168), .A1(n182), .B0(n144), .Y(n197) );
  AO21X2 U11 ( .A0(n127), .A1(n117), .B0(n134), .Y(n131) );
  OA21X2 U12 ( .A0(n57), .A1(n20), .B0(n72), .Y(n206) );
  AO21X2 U13 ( .A0(n28), .A1(n6), .B0(n119), .Y(n205) );
  INVX1 U14 ( .A(n4), .Y(n2) );
  INVX2 U15 ( .A(n145), .Y(n6) );
  AO21X2 U16 ( .A0(pixel_in_reg[1]), .A1(pixel_in_reg[0]), .B0(pixel_in_reg[2]), .Y(n28) );
  NAND3X2 U17 ( .A(n218), .B(n219), .C(pixel_in_reg[4]), .Y(n8) );
  INVXL U18 ( .A(n70), .Y(n4) );
  NAND2XL U19 ( .A(pixel_in_reg[0]), .B(n57), .Y(n70) );
  NOR2X1 U20 ( .A(pixel_in_reg[2]), .B(pixel_in_reg[1]), .Y(n79) );
  NAND2X2 U21 ( .A(pixel_in_reg[0]), .B(n136), .Y(n176) );
  NOR2X1 U22 ( .A(pixel_in_reg[0]), .B(n147), .Y(n73) );
  NAND2X2 U23 ( .A(pixel_in_reg[0]), .B(n79), .Y(n95) );
  NAND3X2 U24 ( .A(n218), .B(n217), .C(pixel_in_reg[3]), .Y(n94) );
  NOR2X2 U25 ( .A(n162), .B(pixel_in_reg[4]), .Y(n97) );
  NOR4BX1 U26 ( .AN(n112), .B(n149), .C(n37), .D(n36), .Y(n171) );
  OAI21X1 U27 ( .A0(n126), .A1(n73), .B0(n6), .Y(n112) );
  AOI2BB2X1 U28 ( .B0(n189), .B1(n85), .A0N(n84), .A1N(n202), .Y(n106) );
  NOR2X2 U29 ( .A(pixel_in_reg[0]), .B(n153), .Y(n167) );
  NAND2X2 U30 ( .A(n194), .B(n201), .Y(n248) );
  NAND2XL U31 ( .A(pixel_in_reg[5]), .B(pixel_in_reg[4]), .Y(n35) );
  NOR2XL U32 ( .A(n156), .B(n190), .Y(n90) );
  NAND4XL U33 ( .A(n101), .B(n173), .C(n33), .D(n47), .Y(n34) );
  NOR2XL U34 ( .A(n135), .B(n97), .Y(n113) );
  NAND2XL U35 ( .A(n72), .B(n98), .Y(n170) );
  NOR4XL U36 ( .A(n181), .B(n180), .C(n179), .D(n178), .Y(n184) );
  INVXL U37 ( .A(n19), .Y(n33) );
  AOI211XL U38 ( .A0(n136), .A1(n135), .B0(n134), .C0(n133), .Y(n138) );
  NOR2XL U39 ( .A(n192), .B(n155), .Y(n125) );
  NAND2XL U40 ( .A(n167), .B(n157), .Y(n65) );
  NAND2XL U41 ( .A(n52), .B(n158), .Y(n93) );
  NAND4XL U42 ( .A(n8), .B(n33), .C(n170), .D(n25), .Y(n49) );
  NAND2XL U43 ( .A(n182), .B(n127), .Y(n47) );
  OAI211XL U44 ( .A0(n167), .A1(n12), .B0(n24), .C0(n33), .Y(n27) );
  NAND3XL U45 ( .A(n93), .B(n54), .C(n53), .Y(n132) );
  AOI22XL U46 ( .A0(n189), .A1(n215), .B0(n187), .B1(n49), .Y(n50) );
  OAI211XL U47 ( .A0(pixel_in_reg[6]), .A1(n51), .B0(n50), .C0(n201), .Y(n240)
         );
  NAND3XL U48 ( .A(n122), .B(n121), .C(n120), .Y(n242) );
  NAND2X1 U49 ( .A(pixel_in_reg[7]), .B(pixel_in_reg[6]), .Y(n140) );
  INVXL U50 ( .A(n140), .Y(n194) );
  NAND3X1 U51 ( .A(n218), .B(n217), .C(n219), .Y(n145) );
  INVXL U52 ( .A(n79), .Y(n153) );
  INVX1 U53 ( .A(n167), .Y(n77) );
  NOR2X1 U54 ( .A(n77), .B(n94), .Y(n119) );
  NOR2XL U55 ( .A(n6), .B(n119), .Y(n14) );
  NAND2X1 U56 ( .A(n220), .B(pixel_in_reg[1]), .Y(n147) );
  INVX1 U57 ( .A(n147), .Y(n57) );
  NOR2X1 U58 ( .A(n220), .B(pixel_in_reg[1]), .Y(n159) );
  INVX1 U59 ( .A(n159), .Y(n192) );
  NOR2X1 U60 ( .A(pixel_in_reg[0]), .B(n192), .Y(n78) );
  NAND2XL U61 ( .A(n95), .B(n7), .Y(n20) );
  NAND2X1 U62 ( .A(pixel_in_reg[2]), .B(pixel_in_reg[1]), .Y(n108) );
  INVX1 U63 ( .A(n108), .Y(n136) );
  NOR2XL U64 ( .A(n94), .B(n176), .Y(n19) );
  NOR2X1 U65 ( .A(pixel_in_reg[0]), .B(n108), .Y(n52) );
  NAND2X1 U66 ( .A(n159), .B(pixel_in_reg[0]), .Y(n86) );
  INVX1 U67 ( .A(n86), .Y(n182) );
  NOR2XL U68 ( .A(n52), .B(n182), .Y(n191) );
  INVXL U69 ( .A(n191), .Y(n98) );
  NAND2X1 U70 ( .A(pixel_in_reg[4]), .B(pixel_in_reg[3]), .Y(n203) );
  NOR2XL U71 ( .A(pixel_in_reg[5]), .B(n203), .Y(n9) );
  BUFX2 U72 ( .A(n9), .Y(n127) );
  INVX1 U73 ( .A(n127), .Y(n155) );
  NOR2XL U74 ( .A(n155), .B(n28), .Y(n143) );
  INVXL U75 ( .A(n143), .Y(n25) );
  NOR2XL U76 ( .A(n206), .B(n49), .Y(n48) );
  NAND3XL U77 ( .A(n217), .B(n219), .C(pixel_in_reg[5]), .Y(n10) );
  BUFX2 U78 ( .A(n10), .Y(n69) );
  NAND2X1 U79 ( .A(pixel_in_reg[5]), .B(pixel_in_reg[3]), .Y(n162) );
  NAND3XL U80 ( .A(n219), .B(pixel_in_reg[4]), .C(pixel_in_reg[5]), .Y(n11) );
  BUFX2 U81 ( .A(n11), .Y(n190) );
  INVX1 U82 ( .A(n190), .Y(n157) );
  NOR2XL U83 ( .A(n97), .B(n157), .Y(n177) );
  NOR2X1 U84 ( .A(n218), .B(n203), .Y(n168) );
  OAI211XL U85 ( .A0(n69), .A1(n220), .B0(n177), .C0(n12), .Y(n116) );
  INVXL U86 ( .A(n116), .Y(n13) );
  AOI31XL U87 ( .A0(n14), .A1(n48), .A2(n13), .B0(n140), .Y(n209) );
  INVXL U88 ( .A(n209), .Y(n201) );
  INVXL U89 ( .A(n176), .Y(n96) );
  AOI222XL U90 ( .A0(n52), .A1(n72), .B0(n168), .B1(n167), .C0(n96), .C1(n157), 
        .Y(n56) );
  INVX1 U91 ( .A(n69), .Y(n158) );
  NOR2XL U92 ( .A(n77), .B(n155), .Y(n110) );
  OAI22X1 U93 ( .A0(n8), .A1(n95), .B0(n69), .B1(n86), .Y(n123) );
  AOI211XL U94 ( .A0(n158), .A1(n73), .B0(n110), .C0(n123), .Y(n15) );
  OAI211XL U95 ( .A0(n12), .A1(n2), .B0(n56), .C0(n15), .Y(n64) );
  OAI22XL U96 ( .A0(n191), .A1(n145), .B0(n8), .B1(n77), .Y(n124) );
  INVX1 U97 ( .A(n73), .Y(n185) );
  NAND2XL U98 ( .A(n97), .B(n182), .Y(n74) );
  OAI21XL U99 ( .A0(n185), .A1(n12), .B0(n74), .Y(n23) );
  INVX1 U100 ( .A(n97), .Y(n175) );
  NOR2XL U101 ( .A(n175), .B(n108), .Y(n39) );
  AOI211XL U102 ( .A0(n96), .A1(n6), .B0(n119), .C0(n39), .Y(n17) );
  INVX1 U103 ( .A(n95), .Y(n126) );
  OAI21XL U104 ( .A0(n126), .A1(n57), .B0(n127), .Y(n16) );
  NAND3XL U105 ( .A(n17), .B(n65), .C(n16), .Y(n165) );
  INVXL U106 ( .A(n165), .Y(n172) );
  NOR2XL U107 ( .A(n69), .B(n2), .Y(n118) );
  NOR2XL U108 ( .A(n8), .B(n176), .Y(n38) );
  AOI211XL U109 ( .A0(n126), .A1(n168), .B0(n118), .C0(n38), .Y(n18) );
  INVXL U110 ( .A(n18), .Y(n103) );
  AOI211XL U111 ( .A0(n158), .A1(n20), .B0(n19), .C0(n103), .Y(n21) );
  OAI211XL U112 ( .A0(n162), .A1(n7), .B0(n172), .C0(n21), .Y(n22) );
  NOR4XL U113 ( .A(n64), .B(n124), .C(n23), .D(n22), .Y(n46) );
  NAND2X1 U114 ( .A(pixel_in_reg[6]), .B(n5), .Y(n202) );
  OAI21XL U115 ( .A0(pixel_in_reg[2]), .A1(pixel_in_reg[1]), .B0(n97), .Y(n24)
         );
  OAI21XL U116 ( .A0(pixel_in_reg[4]), .A1(n219), .B0(n25), .Y(n26) );
  AOI22XL U117 ( .A0(pixel_in_reg[7]), .A1(n27), .B0(n194), .B1(n26), .Y(n45)
         );
  NOR2X1 U118 ( .A(pixel_in_reg[6]), .B(n5), .Y(n189) );
  NAND2XL U119 ( .A(n136), .B(n127), .Y(n66) );
  OAI211XL U120 ( .A0(n69), .A1(n28), .B0(n47), .C0(n66), .Y(n29) );
  NOR2XL U121 ( .A(n205), .B(n29), .Y(n139) );
  OAI211XL U122 ( .A0(n136), .A1(n8), .B0(n139), .C0(n65), .Y(n43) );
  NOR2X1 U123 ( .A(pixel_in_reg[7]), .B(pixel_in_reg[6]), .Y(n187) );
  INVX1 U124 ( .A(n8), .Y(n135) );
  NOR2XL U125 ( .A(n2), .B(n94), .Y(n30) );
  AOI211XL U126 ( .A0(n73), .A1(n135), .B0(n119), .C0(n30), .Y(n68) );
  OAI21XL U127 ( .A0(n157), .A1(n127), .B0(n167), .Y(n101) );
  OAI22XL U128 ( .A0(n108), .A1(n12), .B0(n69), .B1(n185), .Y(n32) );
  OAI22XL U129 ( .A0(n8), .A1(n2), .B0(n94), .B1(n7), .Y(n31) );
  AOI211XL U130 ( .A0(n6), .A1(n52), .B0(n32), .C0(n31), .Y(n173) );
  AOI211XL U131 ( .A0(n78), .A1(n6), .B0(n118), .C0(n34), .Y(n76) );
  OAI22X1 U132 ( .A0(n175), .A1(n153), .B0(n69), .B1(n176), .Y(n149) );
  OAI22XL U133 ( .A0(n203), .A1(n7), .B0(n86), .B1(n35), .Y(n37) );
  OAI22XL U134 ( .A0(n108), .A1(n190), .B0(n69), .B1(n95), .Y(n36) );
  INVX1 U135 ( .A(n52), .Y(n156) );
  NAND2XL U136 ( .A(n156), .B(n95), .Y(n40) );
  AOI211XL U137 ( .A0(n72), .A1(n40), .B0(n39), .C0(n38), .Y(n41) );
  NAND4XL U138 ( .A(n68), .B(n76), .C(n171), .D(n41), .Y(n42) );
  AOI22XL U139 ( .A0(n189), .A1(n43), .B0(n187), .B1(n42), .Y(n44) );
  OAI211XL U140 ( .A0(n46), .A1(n202), .B0(n45), .C0(n44), .Y(n244) );
  NAND3XL U141 ( .A(n177), .B(n69), .C(n66), .Y(n204) );
  INVXL U142 ( .A(n2), .Y(n117) );
  OAI21X1 U143 ( .A0(n117), .A1(n78), .B0(n127), .Y(n137) );
  INVXL U144 ( .A(n214), .Y(n51) );
  NAND2XL U145 ( .A(n48), .B(n12), .Y(n215) );
  OAI21XL U146 ( .A0(n135), .A1(n72), .B0(n57), .Y(n54) );
  OAI21XL U147 ( .A0(n6), .A1(n127), .B0(n73), .Y(n53) );
  NOR2XL U148 ( .A(n158), .B(n72), .Y(n193) );
  INVXL U149 ( .A(n113), .Y(n61) );
  OAI21XL U150 ( .A0(n6), .A1(n61), .B0(n136), .Y(n55) );
  OAI211XL U151 ( .A0(n193), .A1(n176), .B0(n56), .C0(n55), .Y(n196) );
  OAI22XL U152 ( .A0(n12), .A1(n176), .B0(n147), .B1(n190), .Y(n60) );
  NAND2XL U153 ( .A(n145), .B(n12), .Y(n133) );
  INVXL U154 ( .A(n133), .Y(n154) );
  NAND3XL U155 ( .A(pixel_in_reg[5]), .B(pixel_in_reg[4]), .C(n78), .Y(n58) );
  NAND2XL U156 ( .A(n97), .B(n57), .Y(n111) );
  OAI211XL U157 ( .A0(n154), .A1(n70), .B0(n58), .C0(n111), .Y(n59) );
  NOR4XL U158 ( .A(n132), .B(n196), .C(n60), .D(n59), .Y(n107) );
  OAI21XL U159 ( .A0(n6), .A1(n61), .B0(n159), .Y(n62) );
  OAI211XL U160 ( .A0(n108), .A1(n12), .B0(n62), .C0(n93), .Y(n144) );
  OAI22X1 U161 ( .A0(n175), .A1(n95), .B0(n190), .B1(n7), .Y(n181) );
  OAI211XL U162 ( .A0(n190), .A1(n2), .B0(n137), .C0(n112), .Y(n63) );
  NOR4XL U163 ( .A(n144), .B(n64), .C(n181), .D(n63), .Y(n67) );
  NAND4XL U164 ( .A(n68), .B(n67), .C(n66), .D(n65), .Y(n85) );
  NOR2XL U165 ( .A(n69), .B(n77), .Y(n88) );
  OAI22XL U166 ( .A0(n217), .A1(n70), .B0(n8), .B1(n156), .Y(n71) );
  AOI211XL U167 ( .A0(n73), .A1(n72), .B0(n123), .C0(n71), .Y(n75) );
  NAND4BX1 U168 ( .AN(n88), .B(n76), .C(n75), .D(n74), .Y(n180) );
  OAI22XL U169 ( .A0(n219), .A1(n77), .B0(n8), .B1(n7), .Y(n83) );
  OAI22XL U170 ( .A0(n145), .A1(n185), .B0(n86), .B1(n94), .Y(n82) );
  OAI21XL U171 ( .A0(n79), .A1(n78), .B0(n168), .Y(n80) );
  OAI211XL U172 ( .A0(n190), .A1(n156), .B0(n111), .C0(n80), .Y(n81) );
  NOR4XL U173 ( .A(n180), .B(n83), .C(n82), .D(n81), .Y(n84) );
  OAI22XL U174 ( .A0(n12), .A1(n86), .B0(n190), .B1(n185), .Y(n104) );
  OAI21XL U175 ( .A0(pixel_in_reg[5]), .A1(pixel_in_reg[4]), .B0(n162), .Y(n89) );
  OAI22XL U176 ( .A0(n192), .A1(n94), .B0(n176), .B1(n155), .Y(n87) );
  AOI211XL U177 ( .A0(n117), .A1(n89), .B0(n88), .C0(n87), .Y(n92) );
  AOI211XL U178 ( .A0(n135), .A1(n98), .B0(n90), .C0(n181), .Y(n91) );
  NAND2XL U179 ( .A(n92), .B(n91), .Y(n166) );
  OAI21XL U180 ( .A0(n95), .A1(n94), .B0(n93), .Y(n179) );
  AOI211XL U181 ( .A0(n96), .A1(n133), .B0(n166), .C0(n179), .Y(n100) );
  OAI21XL U182 ( .A0(n167), .A1(n98), .B0(n97), .Y(n99) );
  NAND4XL U183 ( .A(n101), .B(n100), .C(n137), .D(n99), .Y(n102) );
  OAI31XL U184 ( .A0(n104), .A1(n103), .A2(n102), .B0(n187), .Y(n105) );
  OAI211XL U185 ( .A0(n107), .A1(n140), .B0(n106), .C0(n105), .Y(n246) );
  NOR2XL U186 ( .A(n190), .B(n167), .Y(n134) );
  NOR2XL U187 ( .A(n8), .B(n108), .Y(n109) );
  OAI211XL U188 ( .A0(n113), .A1(n192), .B0(n146), .C0(n112), .Y(n114) );
  NOR4XL U189 ( .A(n134), .B(n125), .C(n206), .D(n114), .Y(n115) );
  INVXL U190 ( .A(n187), .Y(n207) );
  INVXL U191 ( .A(n202), .Y(n212) );
  OAI21XL U192 ( .A0(n131), .A1(n215), .B0(n212), .Y(n121) );
  OAI31XL U193 ( .A0(n119), .A1(n6), .A2(n118), .B0(n189), .Y(n120) );
  INVXL U194 ( .A(n123), .Y(n129) );
  AOI211XL U195 ( .A0(n127), .A1(n126), .B0(n125), .C0(n124), .Y(n128) );
  OAI211XL U196 ( .A0(n193), .A1(n7), .B0(n129), .C0(n128), .Y(n130) );
  NOR4XL U197 ( .A(n132), .B(n149), .C(n131), .D(n130), .Y(n152) );
  INVXL U198 ( .A(n189), .Y(n216) );
  AOI31XL U199 ( .A0(n139), .A1(n138), .A2(n137), .B0(n216), .Y(n142) );
  AOI211XL U200 ( .A0(pixel_in_reg[3]), .A1(n218), .B0(n217), .C0(n140), .Y(
        n141) );
  AOI211XL U201 ( .A0(n143), .A1(pixel_in_reg[7]), .B0(n142), .C0(n141), .Y(
        n151) );
  OAI211XL U202 ( .A0(n8), .A1(n147), .B0(n146), .C0(n145), .Y(n148) );
  OAI31XL U203 ( .A0(n149), .A1(n197), .A2(n148), .B0(n212), .Y(n150) );
  OAI211XL U204 ( .A0(n152), .A1(n207), .B0(n151), .C0(n150), .Y(n243) );
  OAI22XL U205 ( .A0(n154), .A1(n7), .B0(n8), .B1(n153), .Y(n164) );
  NAND2XL U206 ( .A(n159), .B(n158), .Y(n160) );
  OAI211XL U207 ( .A0(n185), .A1(n162), .B0(n161), .C0(n160), .Y(n163) );
  NOR4XL U208 ( .A(n166), .B(n165), .C(n164), .D(n163), .Y(n200) );
  OAI21XL U209 ( .A0(n168), .A1(n217), .B0(n167), .Y(n169) );
  OAI211XL U210 ( .A0(n8), .A1(n192), .B0(n170), .C0(n169), .Y(n174) );
  NAND4BX1 U211 ( .AN(n174), .B(n173), .C(n172), .D(n171), .Y(n188) );
  OAI22XL U212 ( .A0(n177), .A1(n176), .B0(n175), .B1(n7), .Y(n178) );
  NAND2XL U213 ( .A(n6), .B(n182), .Y(n183) );
  OAI211XL U214 ( .A0(n185), .A1(n203), .B0(n184), .C0(n183), .Y(n186) );
  AOI22XL U215 ( .A0(n189), .A1(n188), .B0(n187), .B1(n186), .Y(n199) );
  OAI22XL U216 ( .A0(n193), .A1(n192), .B0(n191), .B1(n190), .Y(n195) );
  OAI31XL U217 ( .A0(n197), .A1(n196), .A2(n195), .B0(n194), .Y(n198) );
  OAI211XL U218 ( .A0(n200), .A1(n202), .B0(n199), .C0(n198), .Y(n245) );
  NAND4XL U219 ( .A(n216), .B(n12), .C(n202), .D(n201), .Y(n247) );
  OAI21XL U220 ( .A0(n220), .A1(n203), .B0(n218), .Y(n211) );
  NOR3XL U221 ( .A(n206), .B(n205), .C(n204), .Y(n208) );
  NOR2XL U222 ( .A(n208), .B(n207), .Y(n210) );
  AOI211XL U223 ( .A0(n212), .A1(n211), .B0(n210), .C0(n209), .Y(n213) );
  OAI31XL U224 ( .A0(n216), .A1(n215), .A2(n214), .B0(n213), .Y(n241) );
endmodule
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
