john777100/Image_Signal_Processor/top.v

`include "define.v"
`include "demosaic_nostart.v"
`include "denoise.v"
`include "Mean.v"
`include "Gain.v"
`include "WB.v"
`include "gamma.v"
module top(
	input						clk,
	input						rst_n,
	input 	[`COLOR_DEPTH-1:0]	pixel_in,
	input						valid_in,
	input	[`COLOR_BIT_CNT-1:0]color_in,
	input						last_col_in,
	input						last_pic_in,
	input	[`MODE_BIT_CNT-1:0]	mode_in,
	output 	[`COLOR_DEPTH-1:0]	pixel_out,
	output						valid_out,
	output  [`COLOR_BIT_CNT-1:0]color_out,
	output						last_col_out,
	output						last_pic_out,
	output						finish_operation


);

	
	//IO reg
	reg	[`COLOR_DEPTH-1:0]	pixel_in_reg;    
	reg						valid_in_reg;    
	reg	[`COLOR_BIT_CNT-1:0]color_in_reg;    
	reg						last_col_in_reg; 
	reg						last_pic_in_reg; 
	reg	[`MODE_BIT_CNT-1:0]	mode_reg;       
	reg	[`COLOR_DEPTH-1:0]	pixel_out_reg,   n_pixel_out_reg;
	reg						valid_out_reg,   n_valid_out_reg;
	reg	[`COLOR_BIT_CNT-1:0]color_out_reg,   n_color_out_reg;
	reg						last_col_out_reg,n_last_col_out_reg;
	reg						last_pic_out_reg,n_last_pic_out_reg;
	reg						finish_reg, n_finish_reg;

	
	assign pixel_out   		= pixel_out_reg;
	assign valid_out   		= valid_out_reg;
	assign color_out   		= color_out_reg;
	assign last_col_out		= last_col_out_reg;
	assign last_pic_out		= last_pic_out_reg;
	assign finish_operation = finish_reg;

//	reg		[4:0]				size_top, n_size_top;
//	reg		[`GAIN_BIT_CNT-1:0]	k_r_reg, n_k_r_reg;
//	reg		[`GAIN_BIT_CNT-1:0]	k_g_reg, n_k_g_reg;
//	reg		[`GAIN_BIT_CNT-1:0]	k_b_reg, n_k_b_reg;
//	reg		[`COLOR_DEPTH-1:0]	r_mean_reg, n_r_mean_reg;
//	reg		[`COLOR_DEPTH-1:0]	g_mean_reg, n_g_mean_reg;
//	reg		[`COLOR_DEPTH-1:0]	b_mean_reg, n_b_mean_reg;

  
	localparam  r_mean_local = 8'b00010110;
	localparam  g_mean_local = 8'b00100110;
	localparam  b_mean_local = 8'b00010110;
	localparam 	k_r_local = 16'b0000000100111010;
	localparam 	k_g_local = 16'b0000000010110101;
	localparam 	k_b_local = 16'b0000000100111010;
	


	//wire 	[`COLOR_DEPTH-1:0]	pixel_in;
	//wire 						valid_in;
	//wire 	[`COLOR_BIT_CNT-1:0]color_in;
	//wire 						last_col_in;
	//wire 						last_pic_in;
	//wire 	[`COLOR_DEPTH-1:0]	pixel_out;
	//wire 						valid_out;
	//wire 	[`COLOR_BIT_CNT-1:0]color_out;
	//wire 						last_col_out;
	//wire 						last_pic_out;

	wire 	[`COLOR_DEPTH-1:0]	pixel_in_dem;
	wire 						valid_in_dem;
	wire 	[`COLOR_BIT_CNT-1:0]color_in_dem;
	wire 						last_col_in_dem;
	wire 						last_pic_in_dem;
	wire 	[`COLOR_DEPTH-1:0]	pixel_out_dem;
	wire 						valid_out_dem;
	wire 	[`COLOR_BIT_CNT-1:0]color_out_dem;
	wire 						last_col_out_dem;
	wire 						last_pic_out_dem;

	assign pixel_in_dem		= mode_reg == `STAGE14 || mode_reg == `STAGE11 ? pixel_in_reg : 8'd0;
	assign valid_in_dem		= mode_reg == `STAGE14 || mode_reg == `STAGE11 ? valid_in_reg : 1'b0;		
	assign color_in_dem		= mode_reg == `STAGE14 || mode_reg == `STAGE11 ? color_in_reg : `VOID;		
	assign last_col_in_dem	= mode_reg == `STAGE14 || mode_reg == `STAGE11 ? last_col_in_reg : 1'b0;	
	assign last_pic_in_dem	= mode_reg == `STAGE14 || mode_reg == `STAGE11 ? last_pic_in_reg : 1'b0;	
	


	wire 	[`COLOR_DEPTH-1:0]	pixel_in_den;
	wire 						valid_in_den;
	wire 	[`COLOR_BIT_CNT-1:0]color_in_den;
	wire 						last_col_in_den;
	wire 						last_pic_in_den;
	wire 	[`COLOR_DEPTH-1:0]	pixel_out_den;
	wire 						valid_out_den;
	wire 	[`COLOR_BIT_CNT-1:0]color_out_den;
	wire 						last_col_out_den;
	wire 						last_pic_out_den;

	assign pixel_in_den		= mode_reg == `STAGE22 ? pixel_in_reg : pixel_out_dem;
	assign valid_in_den		= mode_reg == `STAGE22 ? valid_in_reg : valid_out_dem;		
	assign color_in_den		= mode_reg == `STAGE22 ? color_in_reg : color_out_dem;
	assign last_col_in_den	= mode_reg == `STAGE22 ? last_col_in_reg	: last_col_out_dem;
	assign last_pic_in_den	= mode_reg == `STAGE22 ? last_pic_in_reg	: last_pic_out_dem;

	wire 	[`COLOR_DEPTH-1:0]	pixel_in_mean;
	wire 						valid_in_mean;
	wire 	[`COLOR_BIT_CNT-1:0]color_in_mean;
	wire 						last_pic_in_mean;
	wire 	[`COLOR_DEPTH-1:0]	r_mean_out_mean;
	wire 	[`COLOR_DEPTH-1:0]	g_mean_out_mean;
	wire 	[`COLOR_DEPTH-1:0]	b_mean_out_mean;
	wire 						valid_out_mean;
	wire 	[`COLOR_BIT_CNT-1:0]color_out_mean;
	wire 						last_pic_out_mean;
	wire 						finish_out_mean;

	assign pixel_in_mean	=  mode_reg == `STAGE33 ? pixel_in_reg : pixel_out_den;
	assign valid_in_mean	=  mode_reg == `STAGE33 ? valid_in_reg : valid_out_den;		
	assign color_in_mean	=  mode_reg == `STAGE33 ? color_in_reg : color_out_den;
	assign last_pic_in_mean	=  mode_reg == `STAGE33 ? last_pic_in_reg	: last_pic_out_den;

	wire 						valid_in_gain;
	wire 	[`COLOR_DEPTH-1:0]	r_mean_in_gain;
	wire 	[`COLOR_DEPTH-1:0]	g_mean_in_gain;
	wire 	[`COLOR_DEPTH-1:0]	b_mean_in_gain;
	wire 						valid_out_gain;
	wire 	[`GAIN_BIT_CNT-1:0]	k_r_out_gain;
	wire 	[`GAIN_BIT_CNT-1:0]	k_g_out_gain;
	wire 	[`GAIN_BIT_CNT-1:0]	k_b_out_gain;


	assign valid_in_gain 	= mode_reg == `STAGE44 ? valid_in_reg : finish_out_mean;
	assign r_mean_in_gain	= mode_reg == `STAGE44 ? r_mean_local : r_mean_out_mean;
	assign g_mean_in_gain	= mode_reg == `STAGE44 ? g_mean_local : g_mean_out_mean;
	assign b_mean_in_gain	= mode_reg == `STAGE44 ? b_mean_local : b_mean_out_mean;

	wire						valid_value_in_wb;
	wire 	[`COLOR_DEPTH-1:0]	pixel_in_wb;
	wire 	[`COLOR_BIT_CNT-1:0]color_in_wb;
	wire						valid_gain_in_wb;
	wire 						last_pic_in_wb;
	wire 	[`GAIN_BIT_CNT-1:0]	k_r_in_wb;
	wire 	[`GAIN_BIT_CNT-1:0]	k_g_in_wb;
	wire 	[`GAIN_BIT_CNT-1:0]	k_b_in_wb;
	wire						valid_value_out_wb;
	wire 	[`COLOR_DEPTH-1:0]	pixel_out_wb;
	wire 	[`COLOR_BIT_CNT-1:0]color_out_wb;
	wire 						last_pic_out_wb;

	
	assign valid_value_in_wb	= valid_in_reg;
	assign pixel_in_wb			= pixel_in_reg; 
	assign color_in_wb			= color_in_reg;
	assign last_pic_in_wb		= last_pic_in_reg;
	assign valid_gain_in_wb		= mode_reg == `STAGE55 ? last_col_in : valid_out_gain; /// ?????
	assign k_r_in_wb			= mode_reg == `STAGE55 ? k_r_local :  k_r_out_gain;
	assign k_g_in_wb			= mode_reg == `STAGE55 ? k_g_local :  k_g_out_gain;
	assign k_b_in_wb			= mode_reg == `STAGE55 ? k_b_local :  k_b_out_gain;

//	assign valid_gain_in_wb		= 1'b1;
//	assign k_r_in_wb			= k_r_local;
//	assign k_g_in_wb			= k_g_local;
//	assign k_b_in_wb			= k_b_local;


	wire 	[`COLOR_DEPTH-1:0]	pixel_in_gamma;
	wire 						valid_in_gamma;
	wire 	[`COLOR_BIT_CNT-1:0]color_in_gamma;
	wire 						last_pic_in_gamma;
	wire 	[`COLOR_DEPTH-1:0]	pixel_out_gamma;
	wire 						valid_out_gamma;
	wire 	[`COLOR_BIT_CNT-1:0]color_out_gamma;
	wire 						last_pic_out_gamma;

	assign pixel_in_gamma 		= mode_reg == `STAGE66 ? pixel_in_reg : pixel_out_wb;
	assign valid_in_gamma		= mode_reg == `STAGE66 ? valid_in_reg : valid_value_out_wb;
	assign color_in_gamma		= mode_reg == `STAGE66 ? color_in_reg : color_out_wb;
	assign last_pic_in_gamma	= mode_reg == `STAGE66 ? last_pic_out_reg : last_pic_out_wb;

demosaic demosaic(
	.clk(clk),
	.rst_n(rst_n),
	.valid(valid_in_dem),
	.data_in(pixel_in_dem),
	.end_col(last_col_in_dem),
	.end_pic(last_pic_in_dem),
	.RGB_valid(valid_out_dem),
	.RGB_data(pixel_out_dem),
	.color(color_out_dem),
	.col_last(last_col_out_dem),
	.pic_last(last_pic_out_dem)
);
denoise denoise(
	.clk(clk),
	.rst_n(rst_n),
	.pixel_in(pixel_in_den),
	.valid_in(valid_in_den),
	.color_in(color_in_den),
	.last_col_in(last_col_in_den),
	.last_pic_in(last_pic_in_den),
	.pixel_out(pixel_out_den),
	.valid_out(valid_out_den),
	.color_out(color_out_den),
	.last_col_out(last_col_out_den),
	.last_pic_out(last_pic_out_den)
);


Mean mean(
	.clk(clk), 
	.rst_n(rst_n),
	.valid_i(valid_in_mean),  //from denoise 
	.color_i(color_in_mean),
	.value_i(pixel_in_mean),
	.last_i(last_pic_in_mean), //finish signal
	.size_i(5'd20), //(k+m) specify images size 2^k * 2^m 
	.r_mean_o(r_mean_out_mean),
	.g_mean_o(g_mean_out_mean),
	.b_mean_o(b_mean_out_mean),
	.valid_o(valid_out_mean),	// ???
	.color_o(color_out_mean),	// ???
	.last_o(last_pic_out_mean),	// ???
	.finish_o(finish_out_mean)
);

Gain gain(
	.clk(clk),
	.rst_n(rst_n),
	.valid_i(valid_in_gain),
	.r_mean_i(r_mean_in_gain),
	.g_mean_i(g_mean_in_gain),
	.b_mean_i(b_mean_in_gain),
	.K_R_o(k_r_out_gain),
	.K_G_o(k_g_out_gain),
	.K_B_o(k_b_out_gain),
	.valid_gain_o(valid_out_gain) //change to valid_gain
	);

WB wb(
	.clk(clk),
	.rst_n(rst_n),
	.valid_value_i(valid_value_in_wb), //mode 2(WB ->GAMMA ->OUTPUT) start
	.color_i(color_in_wb),
	.value_i(pixel_in_wb),
	.valid_gain_i(valid_gain_in_wb),
	.last_i(last_pic_in_wb),
	.K_R(k_r_in_wb),
	.K_G(k_g_in_wb),
	.K_B(k_b_in_wb),
	.value_o(pixel_out_wb),
	.valid_o(valid_value_out_wb),
	.color_o(color_out_wb),
	.last_o(last_pic_out_wb)
	);

gamma_122 gamma(
	.clk(clk),
	.rst_n(rst_n),
	.pixel_in(pixel_in_gamma),
	.valid_in(valid_in_gamma),
	.color_in(color_in_gamma),
	.last_pic_in(last_pic_in_gamma),
	.pixel_out(pixel_out_gamma),
	.valid_out(valid_out_gamma),
	.color_out(color_out_gamma),
	.last_pic_out(last_pic_out_gamma)
);

always@(*) begin
	n_pixel_out_reg = pixel_out_reg;
	n_valid_out_reg = valid_out_reg;
	n_color_out_reg = color_out_reg;
	n_last_col_out_reg = 1'b0;
	n_last_pic_out_reg = 1'b0;
	n_finish_reg = 1'b0; 
	case(mode_reg)
		`STAGE11:begin
			n_pixel_out_reg =    pixel_out_dem;
			n_valid_out_reg =    valid_out_dem;
			n_color_out_reg =    color_out_dem;
			n_last_col_out_reg = last_col_out_dem;
			n_last_pic_out_reg = last_pic_out_dem;
			n_finish_reg = color_out_dem == `BLUE && last_col_out_dem; 
		end
		`STAGE22:begin
			n_pixel_out_reg =    pixel_out_den;
			n_valid_out_reg =    valid_out_den;
			n_color_out_reg =    color_out_den;
			n_last_col_out_reg = last_col_out_den;
			n_last_pic_out_reg = last_pic_out_den;
			n_finish_reg = color_out_den == `BLUE && last_col_out_den; 
		end
		`STAGE33:begin
			n_pixel_out_reg =    color_out_mean == `RED ? r_mean_out_mean :
								 color_out_mean == `GREEN ? g_mean_out_mean :
								 b_mean_out_mean;
			n_valid_out_reg =    valid_out_mean;
			n_color_out_reg =    color_out_mean;
			n_last_pic_out_reg = last_pic_out_mean;
			n_finish_reg = finish_out_mean; 
		end
		`STAGE44:begin
			n_pixel_out_reg = 	 k_r_out_gain;
			n_valid_out_reg =    valid_out_gain;
			n_color_out_reg =    `RED;
			n_last_pic_out_reg = 1'b0;
			n_finish_reg = valid_out_gain; 
		end
		`STAGE55:begin
			n_pixel_out_reg = 	 pixel_out_wb;
			n_valid_out_reg =    valid_value_out_wb;
			n_color_out_reg =    color_out_wb;
			n_last_pic_out_reg = last_pic_out_wb;
			n_finish_reg = color_out_wb == `BLUE && last_pic_out_wb; 
		end

		`STAGE66: begin
			n_pixel_out_reg = 	 pixel_out_gamma;
			n_valid_out_reg = 	 valid_out_gamma;
			n_color_out_reg = 	 color_out_gamma;
			n_last_pic_out_reg = last_pic_out_gamma;
			n_finish_reg	= 	 color_out_gamma == `BLUE && last_pic_out_gamma;
		end
		`STAGE14: begin
			n_pixel_out_reg = 	 pixel_out_den;   
			n_valid_out_reg =    valid_out_den;  
			n_color_out_reg =    color_out_den;  
			n_last_col_out_reg = last_col_out_den;
			n_last_pic_out_reg = last_pic_out_den;
			n_finish_reg = valid_out_gain; 
		end
		`STAGE56: begin
			n_pixel_out_reg =    pixel_out_gamma;
			n_valid_out_reg = 	 valid_out_gamma;
			n_color_out_reg = 	 color_out_gamma;
			n_last_pic_out_reg = last_pic_out_gamma;
			n_finish_reg	= 	 color_out_gamma == `BLUE && last_pic_out_gamma;
			
		end
	endcase

end

always@(posedge clk or negedge rst_n) begin
	if(!rst_n) begin
		pixel_in_reg	<= 0;    
		valid_in_reg    <= 0;
		color_in_reg    <= `VOID;
		last_col_in_reg <= 0; 
		last_pic_in_reg <= 0;
		mode_reg		<= `STAGE11;
		pixel_out_reg	<= 0 ;  
		valid_out_reg	<= 0;
		color_out_reg	<= `VOID;   
		last_col_out_reg <= 0;
		last_pic_out_reg <= 0;
		finish_reg 		<=  0;
	end 
	else begin
		pixel_in_reg 	<= pixel_in;     
		valid_in_reg 	<= valid_in;
		color_in_reg 	<= color_in;
		last_col_in_reg <=  last_col_in;
		last_pic_in_reg <=  last_pic_in;
		mode_reg 		<= mode_in;
		pixel_out_reg 	<= n_pixel_out_reg;
		valid_out_reg 	<= n_valid_out_reg;
		color_out_reg 	<= n_color_out_reg;
		last_col_out_reg <= n_last_col_out_reg;
		last_pic_out_reg <= n_last_pic_out_reg;
		finish_reg 		<=  n_finish_reg;
	end
end

endmodule
